ambadran/SIMACAS/Documentation/media/main_sch.jpg

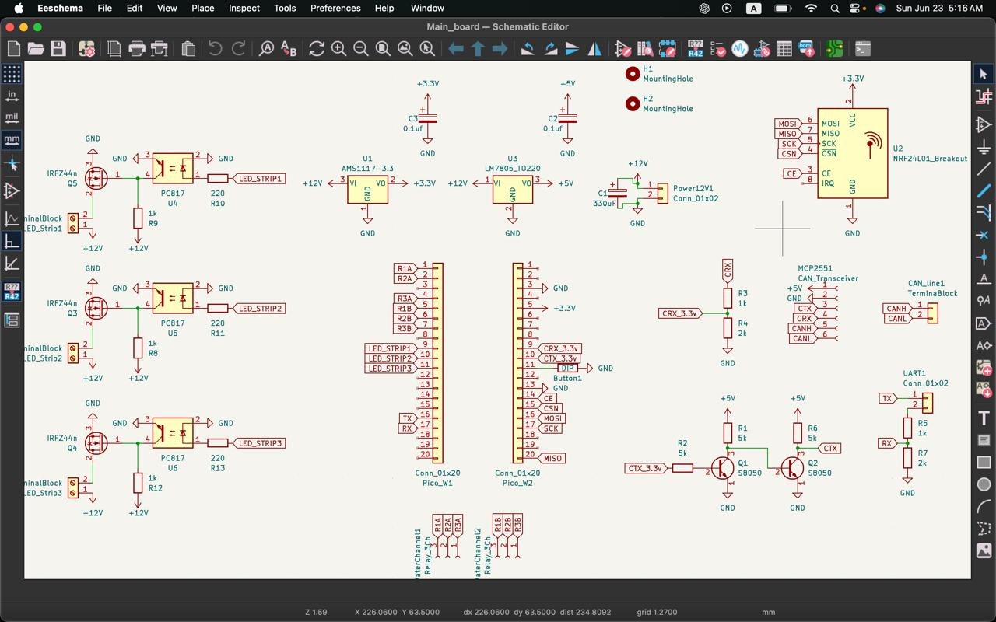
Documentation/media/main_sch.jpg
