ambadran/SIMACAS/Documentation/media/axis_sch.jpg

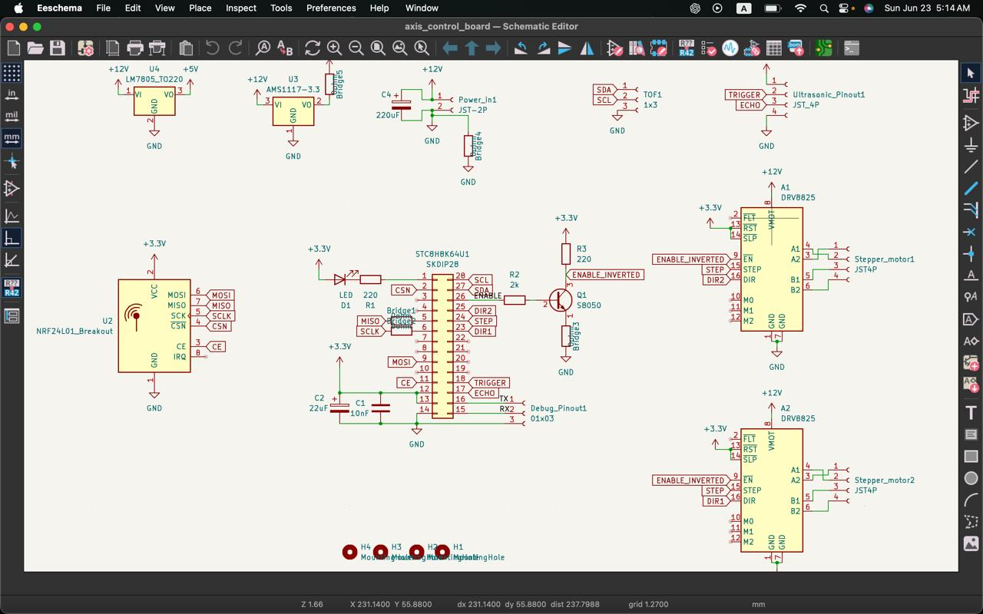
Documentation/media/axis_sch.jpg
