ambadran/SIMACAS/README.md

# SIMACAS - Smart Intillegent Monitoring and Control Agriculture System
