ambadran/SIMACAS/Programming/axis_controller/README.md

# STC8G1K08 Axis MCU

Take in commands from Main MCU through nRF24l01 and gives instructions to two stepper motor drivers DRV8825 to move the railing mechanism through aluminum profiles
