ambadran/SIMACAS/Documentation/media/1-3.png

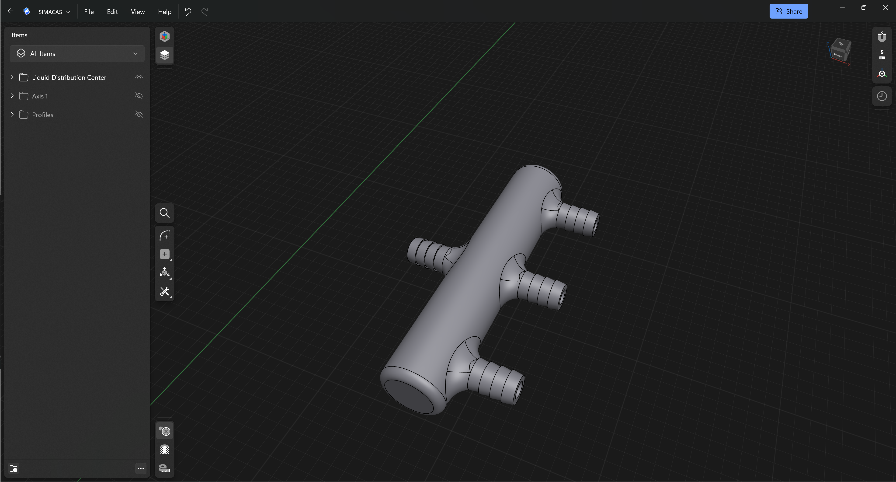
Documentation/media/1-3.png
