ambadran/SIMACAS/Documentation/media/actuators.html.jpg

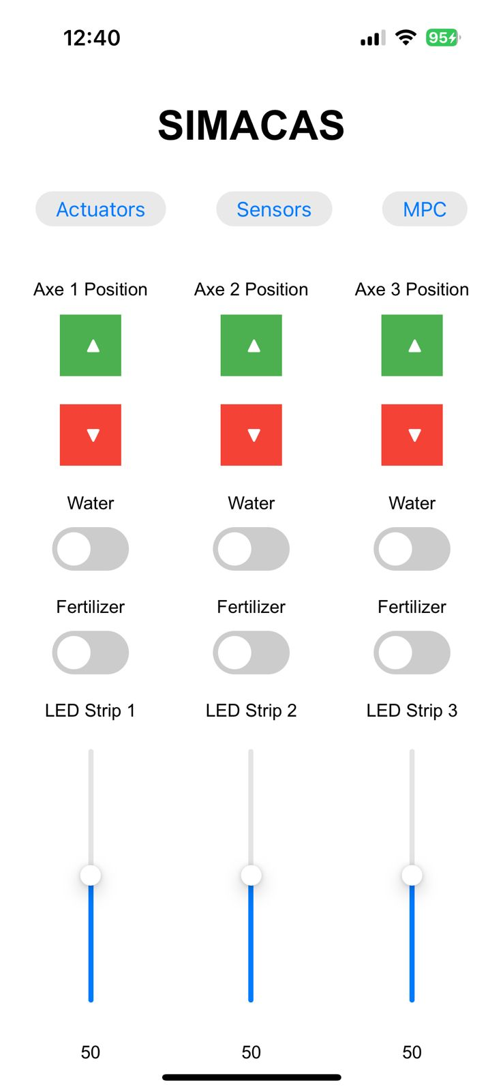
Documentation/media/actuators.html.jpg
