ambadran/SIMACAS/Documentation/media/axis_pcb.jpg

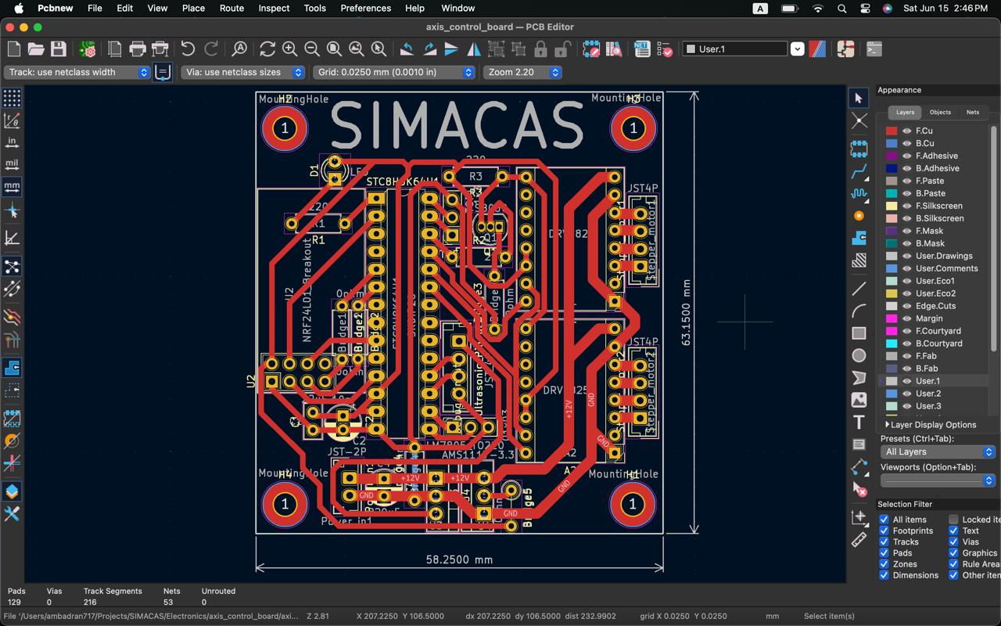
Documentation/media/axis_pcb.jpg
