ambadran/SIMACAS/Documentation/media/high_level_circuit.jpg

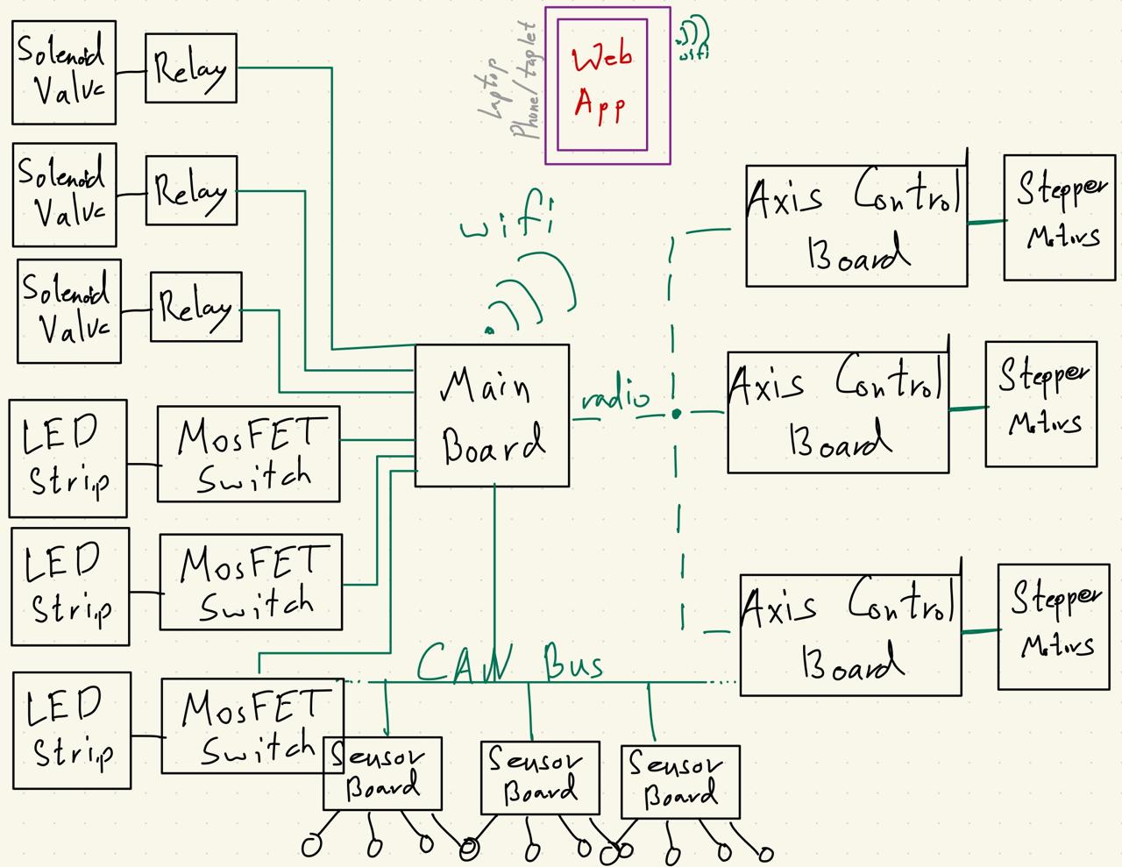
Documentation/media/high_level_circuit.jpg
