ambadran/SIMACAS/Documentation/media/left_axis.png

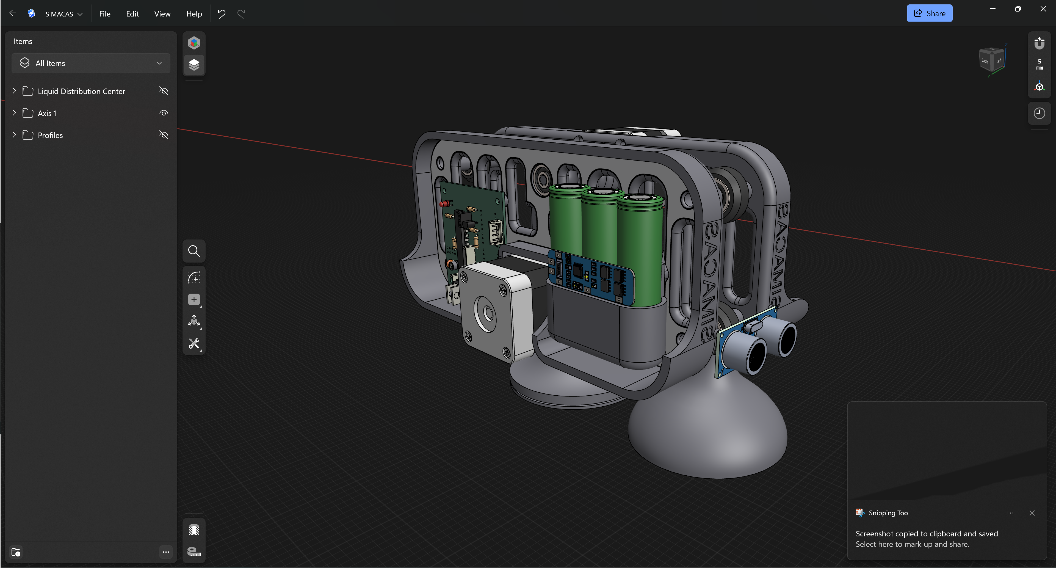
Documentation/media/left_axis.png
