ambadran/SIMACAS/Documentation/media/main_pcb.jpg

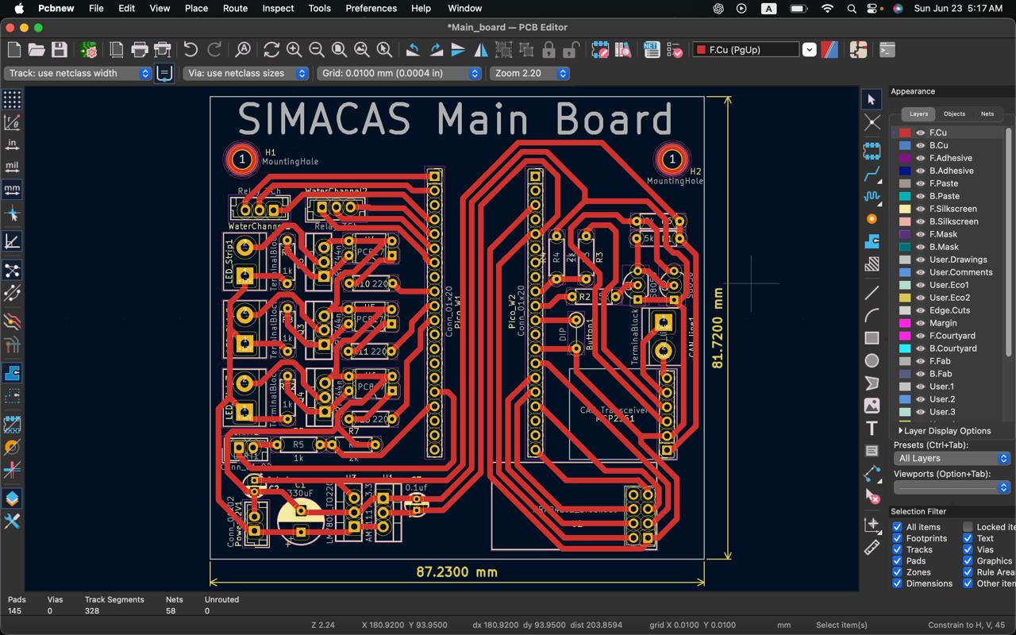
Documentation/media/main_pcb.jpg
