ambadran/SIMACAS/Documentation/media/mpc.html.jpg

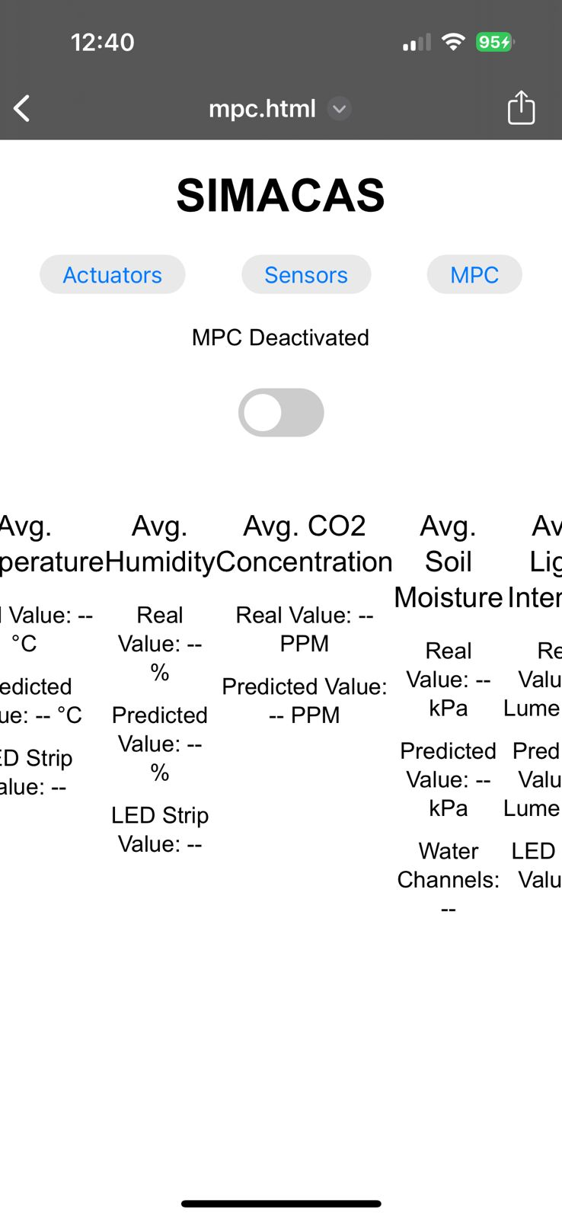
Documentation/media/mpc.html.jpg
