ambadran/SIMACAS/Documentation/media/right_axis.png

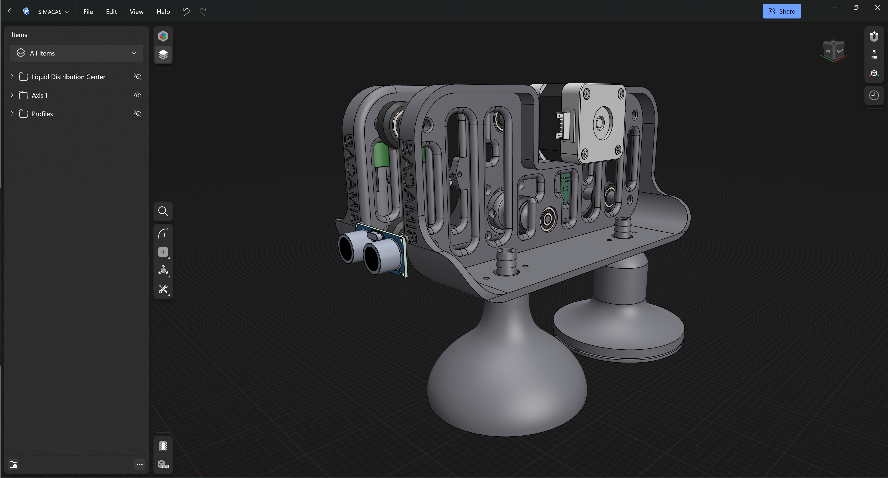
Documentation/media/right_axis.png
