ambadran/SIMACAS/Documentation/media/sensor_pcb.jpg

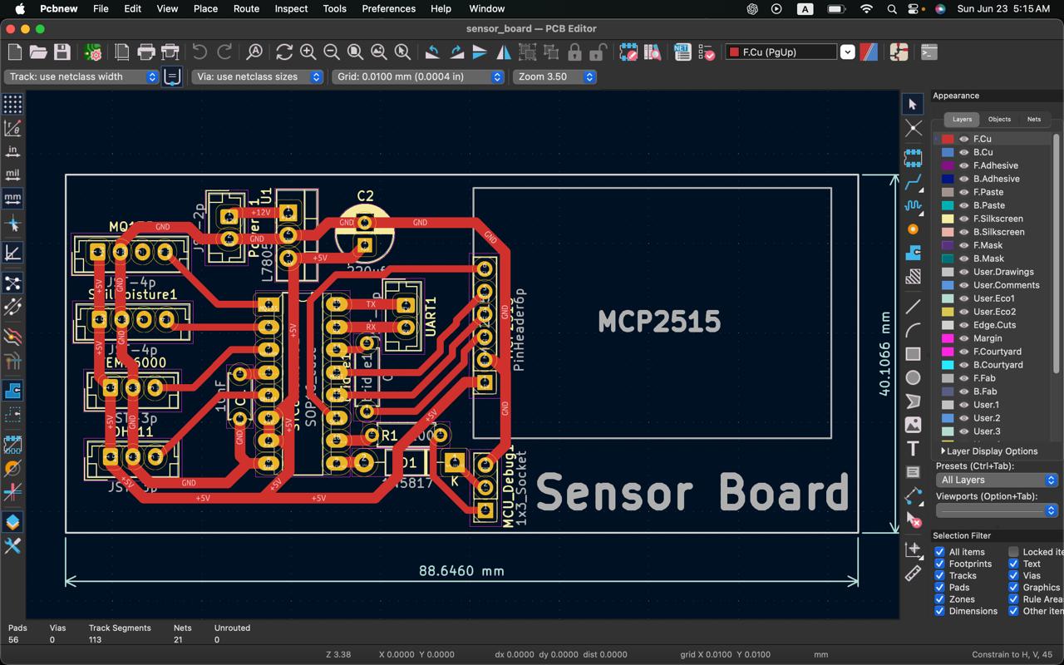
Documentation/media/sensor_pcb.jpg
