ambadran/SIMACAS/Documentation/media/sensor_sch.jpg

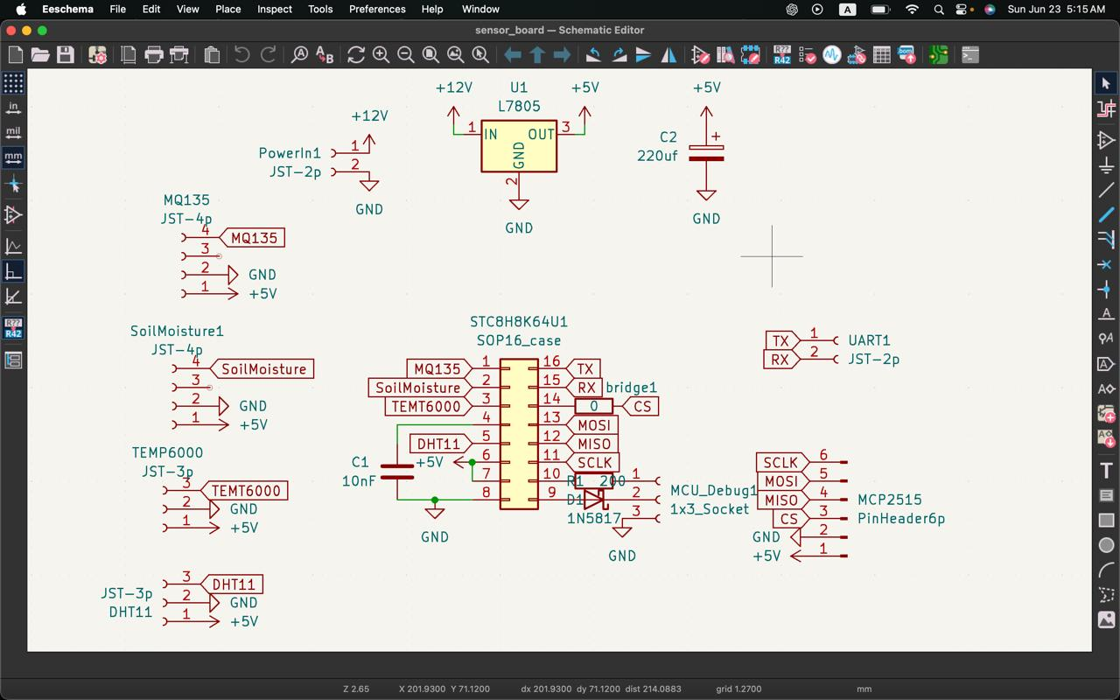
Documentation/media/sensor_sch.jpg
