ambadran/SIMACAS/Documentation/media/sensors.html.jpg

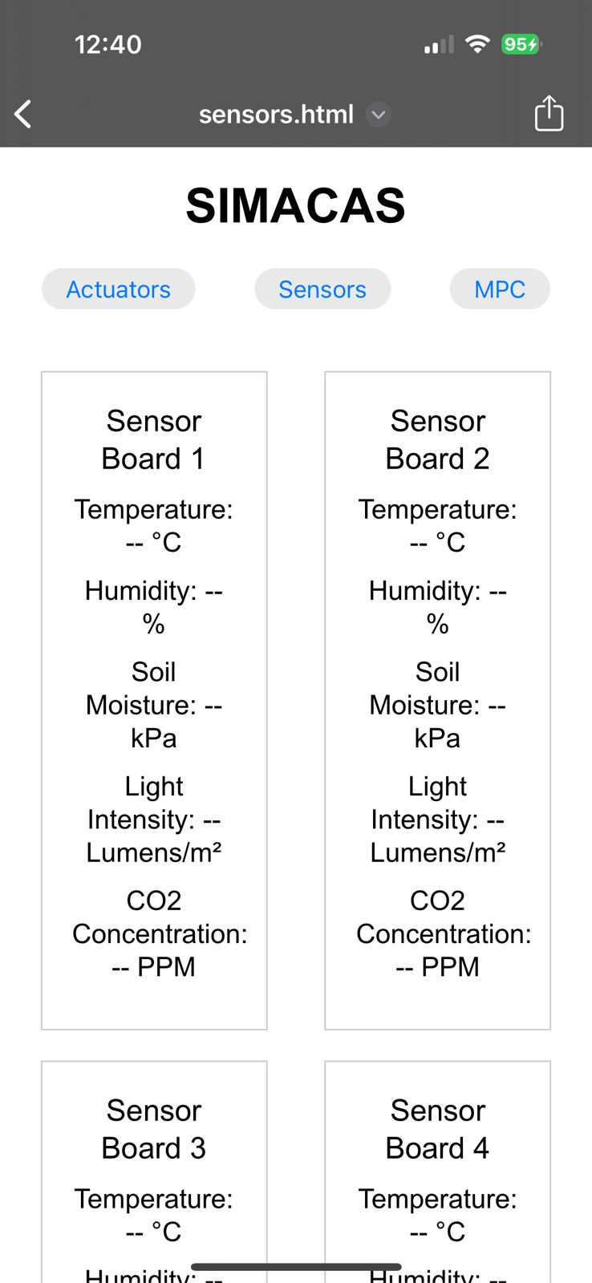
Documentation/media/sensors.html.jpg
