ambadran/SIMACAS/Documentation/media/water_distribution.png

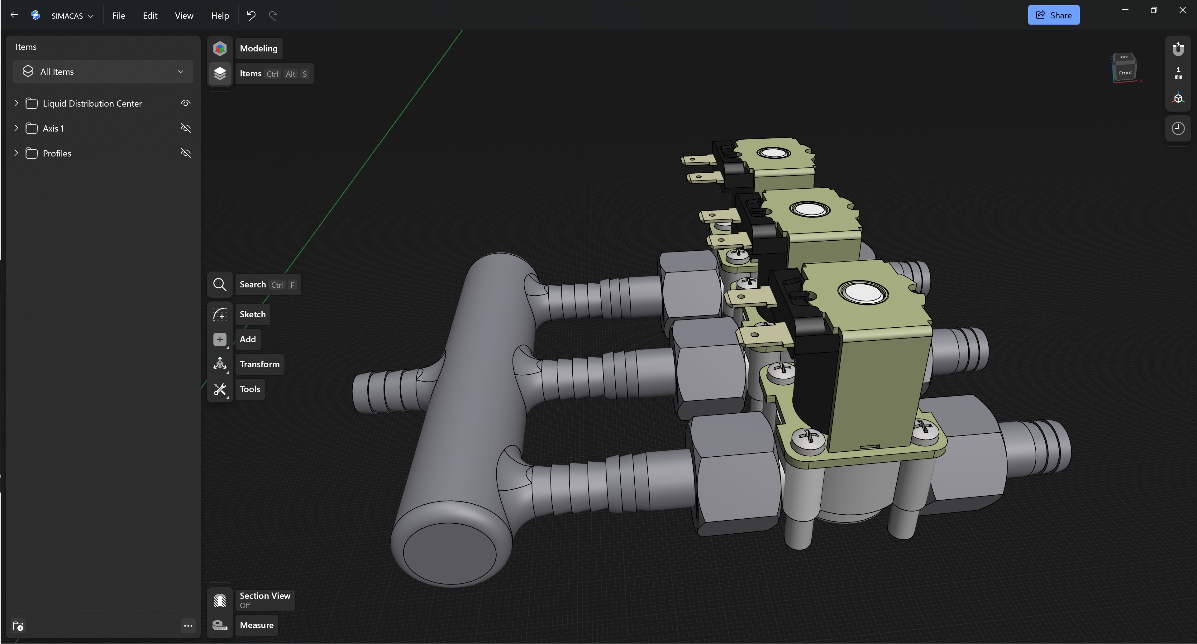
Documentation/media/water_distribution.png
