ambadran/SIMACAS/Documentation/media/water_distribution_circuit.jpg

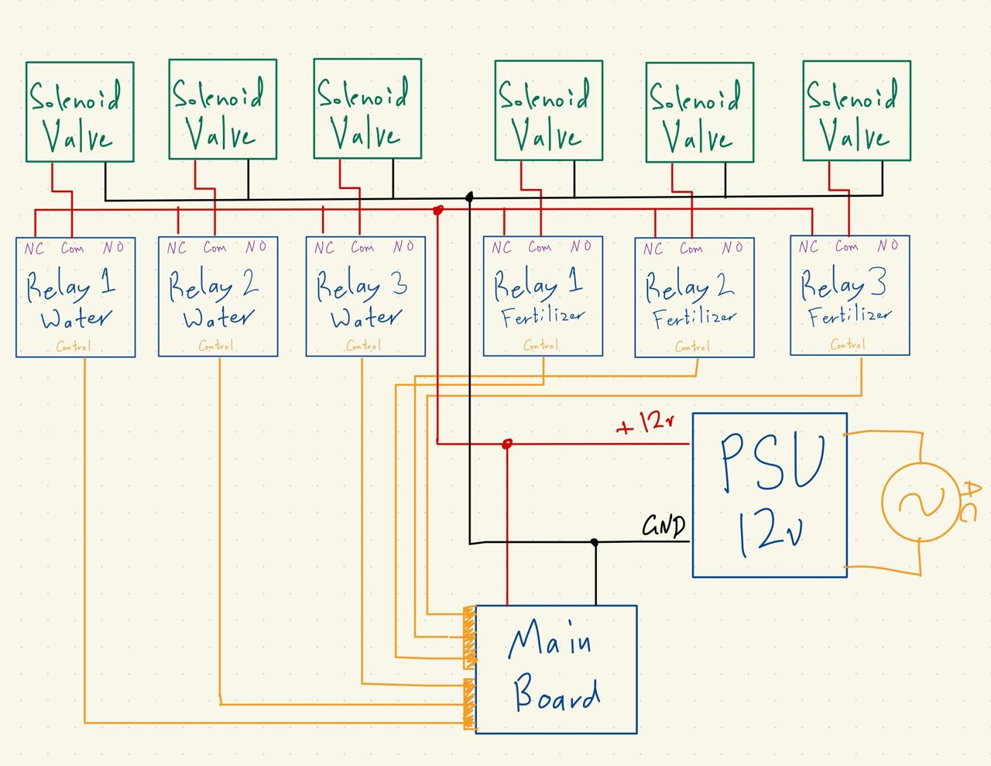
Documentation/media/water_distribution_circuit.jpg
