ambadran/SIMACAS/Documentation/media/wifi.jpg

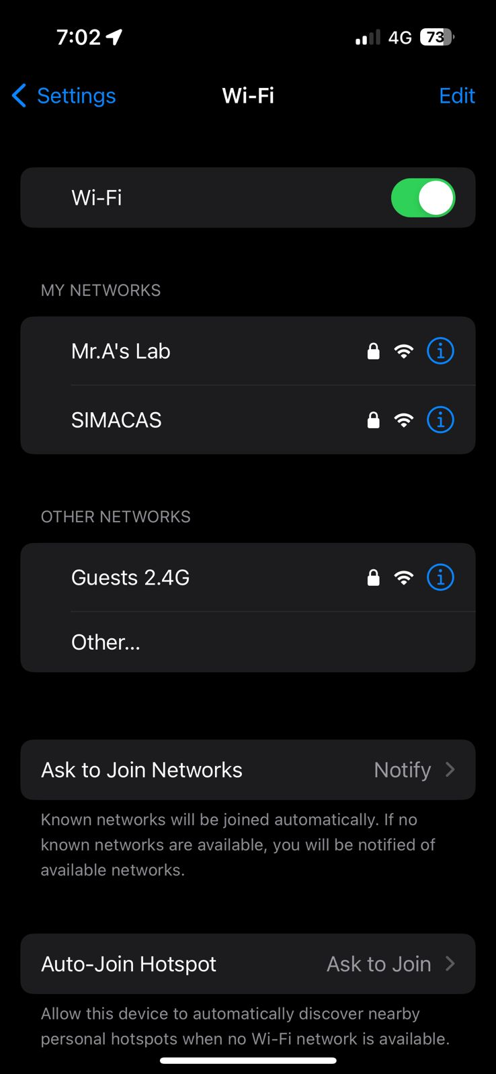
Documentation/media/wifi.jpg
