ambadran/SIMACAS/Documentation/BOM.xlsx

Sheet: Summary
No. | Name | Cost | Quantity | Total Cost | Description | Store
1 | Frame Assembly | 9313 | 1 | 9313
2 | Water Distribution System | 3359 | 1 | 3359
3 | Axis Traversal Robot Assembly | 2846 | 3 | 8538
4 | Power & Control Circuit Assembly | 3344.5 | 1 | 3344.5
*** | NOT BOUGHT |  |  | -2098
<> | Design, Manufacturing, Testing and Documentation |  |  | 20000
 | TOTAL |  |  | 42456.5

Sheet: NOT Bought
No. | Name | Cost | Quantity | Total Cost | Description | Store | Link
1 | Wood Sheet | 750 | 1 | 750
2 | Wood bolts | 1 | 20 | 20
5 | Profile L-Shaped connector | 20 | 12 | 240 | 3D corner connector between Top Frame and legs | UGE | https://uge-one.com/product/industrial-aluminum-profile-2020-european-standard-three-dimensional-angle-corner-connector/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
6 | T-Nut | 6 | 10 | 60 | Including T-Nut
7 | M5 1cm | 3 | 8 | 24
 | LED Strips
3 | Ultrasonic Sensor | 55 | 2 | 110
4 | Ultrasonic Wire | 30 | 2 | 60
5 | Ultrasonic screw | 1 | 4 | 4
6 | Fitting 3/4inch female to 1/2inch hose | 25 | 5 | 125
7 | hose 1/2 diameter | 15 | 27 | 405
8 | 3D printed sprinkler wide | 150 | 2 | 300
9 | LED Strips | 0 | 3 | 0 | not bought
10 | Wires for LED Strips | 0 | 1 | 0 | not bought
2 | STC8H8K64U_SOP20 | 65 | 1 | 65
3 | IC socket DIP28 | 8 | 1 | 8
 | TOTAL |  |  | 2098

Sheet: Frame Assembly
No. | Name | Cost | Quantity | Total Cost | Description | Store | Link
1 | Aluminum Profiles 2040 | 315 | 16 | 5040 | 2040 Profile for base (3+3+2+2+2*3+3) ~ 18m | 3dsmart
2 | Aluminum Profiles 2020 | 195 | 9 | 1755 | 2020 Profile for legs (2m*4) | 3dsmart
3 | Wood sheet | 750 | 1 | 750 | كنتر خشب للbase | المصانع
4 | Profile interior corner connector | 45 | 20 | 900 | inter-connections inside frame | UGE | https://uge-one.com/product/l-shape-3030-aluminum-profile-interior-corner-connector-joint-bracket/
5 | Profile L-Shaped connector | 20 | 24 | 480 | 3D corner connector between Top Frame and legs | UGE | https://uge-one.com/product/industrial-aluminum-profile-2020-european-standard-three-dimensional-angle-corner-connector/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
6 | T-Nut | 6 | 32 | 192 | Including T-Nut
7 | M5 1cm | 3 | 32 | 96
8 | M5 5cm | 4 | 20 | 80
9 | Wood Bolt | 1 | 20 | 20
 | TOTAL |  |  | 9313

Sheet: Axis Traversal Robot Assembly
No. | Name | Cost | Quantity | Total Cost | Description | Store | Link
1 | Left Side Frame | 3 | 180 | 540 | Sprinkler Side – 3D Printed /gram – 180g / Piece – 1 Piece
2 | Right Side Frame | 3 | 101 | 303 | Electronics Side – 3D Printed /gram – 101g / Piece – 1 Piece
3 | Battery Holder | 3 | 28 | 84 | 3D Printed /gram – 14g / Piece – 2 Pieces
4 | Spacers | 3 | 12 | 36 | 3D Printed /gram – 1g /Piece – 12 Pieces
5 | Motor Coupler | 3 | 12 | 36 | 3D Printed /gram – 6g /Piece – 2 Pieces
6 | Coupler Axis Connector | 3 | 4 | 12 | 3D Printed /gram – 2g /Piece – 2 Pieces
7 | V-Wheel Bearing | 55 | 6 | 330 | 2 v-wheels will have the inner ball bearings removed to fit in the coupler
 | Ball Bearings | 30 | 0 | 0 | the removed ball bearings will be used
8 | Stepper Motor | 100 | 2 | 200
10 | Stepper Motor Wire | 30 | 2 | 60
11 | Li-Ion 18650 Batteries | 50 | 3 | 150
12 | Li-Ion BMS 3s | 85 | 1 | 85
13 | Li-Ion Nickel Strips | 10 | 1 | 10
14 | Li-Ion Power Wires with JST | 20 | 1 | 20
15 | Ultrasonic Sensor | 55 | 1 | 55
16 | Ultrasonic Sensor Screw | 1 | 2 | 2
17 | Ultrasonic Sensor Wire | 30 | 1 | 30
18 | Assembled PCB | 877 | 1 | 877 | Details in “axis_control_pcb.xlsx”
9 | M3 Screws | 2 | 8 | 16 | For Stepper Motors, PCB and battery holder mounting
 | TOTAL |  |  | 2846

Sheet: Water Distribution System
No. | Name | Cost | Quantity | Total Cost | Description | Store
1 | hose 1/2 inch diameter | 15 | 30 | 450
2 | Fitting 3/4inch female to 1/2inch hose | 25 | 12 | 300 | From 1/2 inch diameter hose to 3/4 inch inlet of solenoid valve
3 | Water distributer 1 to 3 | 3 | 76 | 228 | 3D printed water distributer from 1 source to 6 outputs
4 | Solenoid Valves | 250 | 6 | 1500
5 | Hose tightenner | 2 | 16 | 32
6 | M3 Screw with nut | 3 | 4 | 12 | to hold sprinklers to axis traversal robot
7 | 3D Printed Sprinklers Narrow output | 3 | 129 | 387 | 1 sprinkler is 43 grams,
8 | 3D Printed Sprinklers Wide output | 3 | 150 | 450 | 1 sprinkler is 50 grams
 | TOTAL |  |  | 3359

Sheet: Power & Control Circuit Assembl
No. | Name | Cost | Quantity | Total Cost | Description | Store | Link
1 | AC head socket | 20 | 1 | 20
2 | AC Wire | 10 | 3 | 30
3 | Power supply 12v 10Amps | 375 | 1 | 375 | for solenoids and relays
4 | Power wire JST 2-pin | 20 | 1 | 20 | To power Main Board
5 | Assembled Main Board | 1639 | 1 | 1639 | Please Refer to “main_board.xlsx”
6 | MDF Board | 40 | 1 | 40 | to Hold Power Supply and Relay Modules
7 | M3 Screw and Nuts | 5 | 6 | 30 | to Hold Power Supply and Relay Modules
8 | Pin Header wires 3P | 5 | 2 | 10 | to connect to each relay modules
9 | Power Wires 1.5mm | 8 | 3 | 24 | To power Relay Channels
10 | Terminals | 2 | 12 | 24 | 2 terminals connectors for each solenoid (6 solenoids)
11 | Relay Module 12V 3Channel | 120 | 2 | 240
12 | MDF Board | 30 | 2 | 60 | to Hold the solenoid valves
13 | M5 Screws and Nuts | 5 | 6 | 30 | To hold the 3 MDF boards
14 | LED Strips | 0 | 3 | 0 | not bought
15 | Wires for LED Strips | 0 | 1 | 0 | not bought
16 | Power Wires 1mm | 6 | 3 | 18 | To connect Main Board to Sensor Board
17 | Assembled Sensor Board | 784.5 | 1 | 784.5 | with sensors
 | TOTAL |  |  | 3344.5

Sheet: Main Board
No. | Name | Cost | Quantity | Total Cost | Description | Store
1 | PCB | 400 | 1 | 400
2 | Pin Headers 1x20 | 12 | 2 | 24 | for raspberry pi pico w
3 | Raspberry Pi Pico W | 850 | 1 | 850
4 | Pin Header 2x3 | 2 | 1 | 2
5 | nRF24l01 | 110 | 1 | 110
6 | Resistors | 1 | 10 | 10
7 | S8050 | 2 | 2 | 4
8 | Pin Header 1x6 | 5 | 1 | 5
9 | MCP2551 | 460 | 1 | 460 | CAN Transceiver | future
10 | Terminal Block | 5 | 4 | 20 | 3 for led strip and 1 for CAN bus
11 | JST 3P Female | 3 | 2 | 6 | To connect to relays of solenoid valve
12 | PC817 | 3 | 3 | 9 | Optocoupler
13 | IRFZ44n | 3 | 25 | 75 | N-channel MOSFET
14 | JST 2P Female | 3 | 2 | 6 | 1 for power and 1 for UART output
15 | LD33v | 35 | 1 | 35 | 3.3v regulator
16 | L7805 | 15 | 1 | 15 | 5v regulator
17 | Capacitor 300uf | 4 | 1 | 4
18 | Capacitor 1nf | 2 | 2 | 4
 | TOTAL |  |  | 1639

Sheet: Axis Control Board
No. | Name | Cost | Quantity | Total Cost | Description | Store
1 | STC8H8K64U1 | 81 | 1 | 81 |  | UGE
2 | Female Pin headers 1x3 | 6 | 1 | 6 | MCU debugging
3 | IC socket 28pin | 7 | 1 | 7
4 | Female Pin Header 2x3 | 10 | 1 | 10 | nRF24 pinout
5 | nRF24l01 | 110 | 1 | 110 |  | circuits-elec
6 | LD33v | 35 | 1 | 35 |  | UGE
7 | lm7805 | 8 | 1 | 8 |  | UGE
9 | Female Pin Header 1x40 | 6 | 1 | 6 | DRV pinout
10 | DRV8825 | 140 | 2 | 280 |  | UGE
11 | S8050 | 3 | 1 | 3
12 | Resistors | 5 | 3 | 15 | 1k, 220x2
13 | JST female 2pin | 2 | 1 | 2 | Power in | UGE
14 | JST female 4pin | 2 | 3 | 6 | 2 stepper motors output and one ultrasonic input/output | UGE
15 | LED | 1 | 1 | 1
16 | Capacitor Electrolytic 220uF | 2 | 1 | 2
17 | Capacitor Electrolytic 22uF | 1 | 1 | 1
18 | Ceramic Capacitor | 2 | 2 | 4
19 | PCB board | 300 | 1 | 300
 | TOTAL |  |  | 877

Sheet: Sensor Board
No. | Name | Cost | Quantity | Total Cost | Description | Store
1 | PCB | 250 | 1 | 250
2 | STC8H8K64U_SOP20 | 65 | 1 | 65
3 | IC socket DIP28 | 8 | 1 | 8
4 | 1n5817 | 1 | 1 | 1 | Diode
5 | Resistors | 1 | 1 | 1
6 | 3-pin header | 2 | 1 | 2 | STC MCU Programming
7 | JST 2Pin | 3 | 2 | 6 | Power Input and UART Port
8 | JST 3Pin | 3 | 2 | 6 | TEMT600 and DHT11
9 | JST 4PIn | 3 | 2 | 6 | MQ135 and soil moisture
10 | Pin Header | 3 | 1 | 3 | MCP2515 breakout
11 | l7805 | 15 | 1 | 15
12 | Capacitor 220uf | 3 | 1 | 3
13 | Capacitor 0.1nF | 1 | 1 | 1
14 | Shrink Tube for wire | 2 | 1 | 2 | all wire lengths
15 | Female Pin header Wires | 5 | 14 | 70
16 | DHT11 | 65 | 1 | 65 | temperature and humidity
17 | MQ135 | 100 | 1 | 100
18 | Soil Moisture Sensor | 75 | 1 | 75
19 | TEMPT6000 | 85.50 | 1 | 85.5 | ambient light sensor
20 | MCP2515 Module | 270 | 1 | 270 | for CAN communication
 | TOTAL |  |  | 784.5
