ambadran/SIMACAS/Mechanics/SIMACAS.step

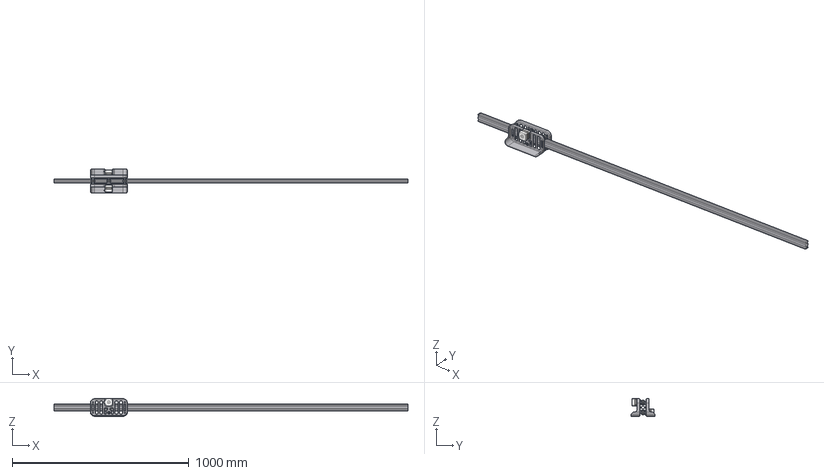
[picture p20: CAD file, 2024-04-13]
Mechanics/SIMACAS.step
2000.0 x 136.1 x 102.0 mm
Spacers (1)
Spacers
Top shaft support
Top Coupling
Top Motor Frame
Bottom Motor Frame
Top Back V Wheel
Bottom Back V Wheel
Top Front V Wheel
Bottom Front V Wheel
Profiles
