ambadran/SIMACAS/Mechanics/STLs/coupler_frame_connector.stl

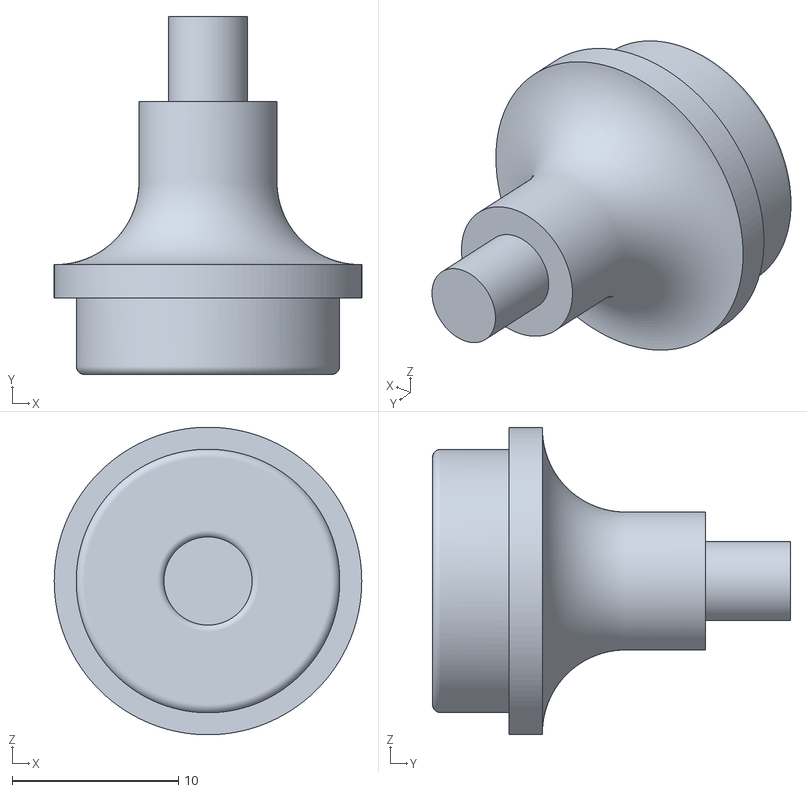
[picture p21: CAD file, 2024-06-25]
Mechanics/STLs/coupler_frame_connector.stl
18.5 x 21.5 x 18.5
