ambadran/SIMACAS/Mechanics/STLs/motor_coupler.stl

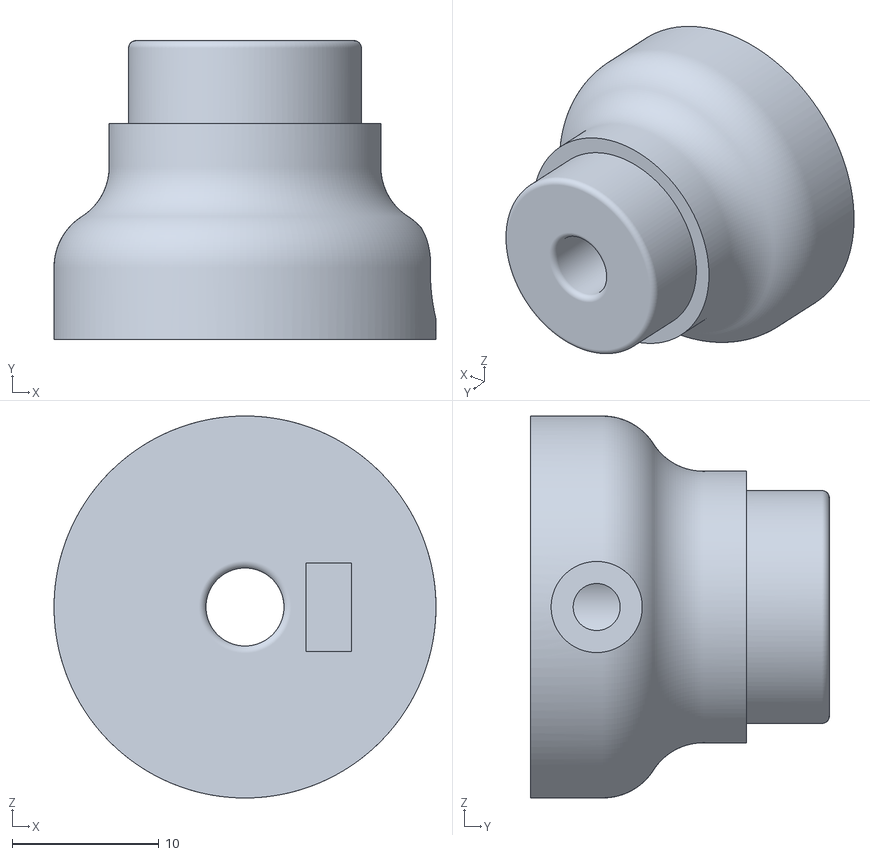
[picture p22: CAD file, 2024-06-25]
Mechanics/STLs/motor_coupler.stl
26.0 x 20.3 x 26.0
