ambadran/SIMACAS/Mechanics/STLs/sprinkler_wide_top.stl

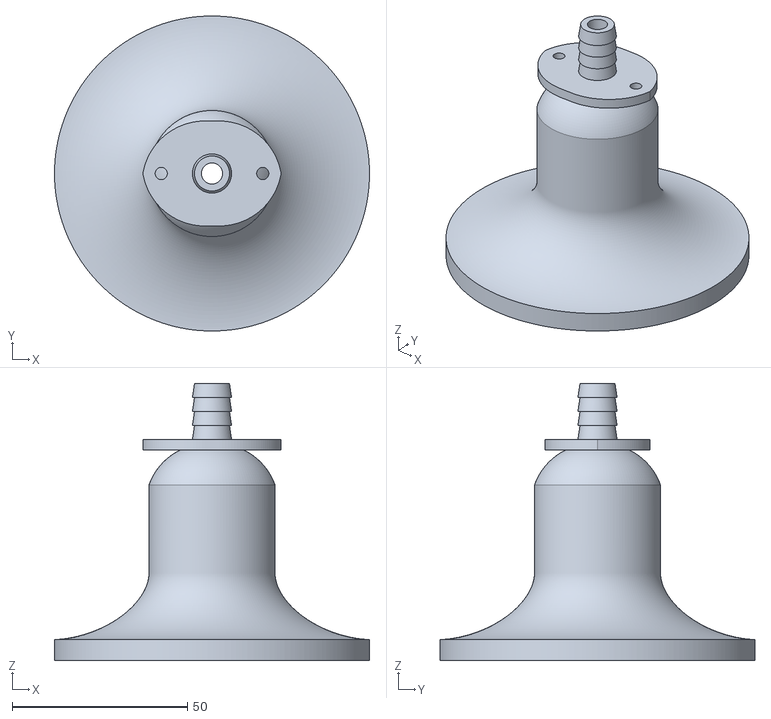
[picture p23: CAD file, 2024-06-23]
Mechanics/STLs/sprinkler_wide_top.stl
90.0 x 90.0 x 79.2
