ambadran/SIMACAS/Mechanics/STLs/sprinkler_wide_base.stl

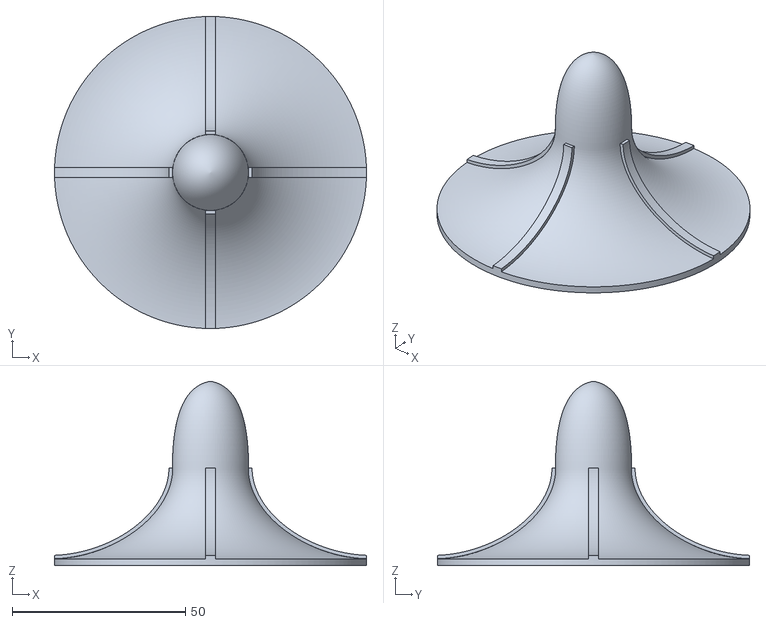
[picture p24: CAD file, 2024-06-23]
Mechanics/STLs/sprinkler_wide_base.stl
90.0 x 90.0 x 53.2
