ambadran/SIMACAS/Mechanics/STLs/spacer.stl

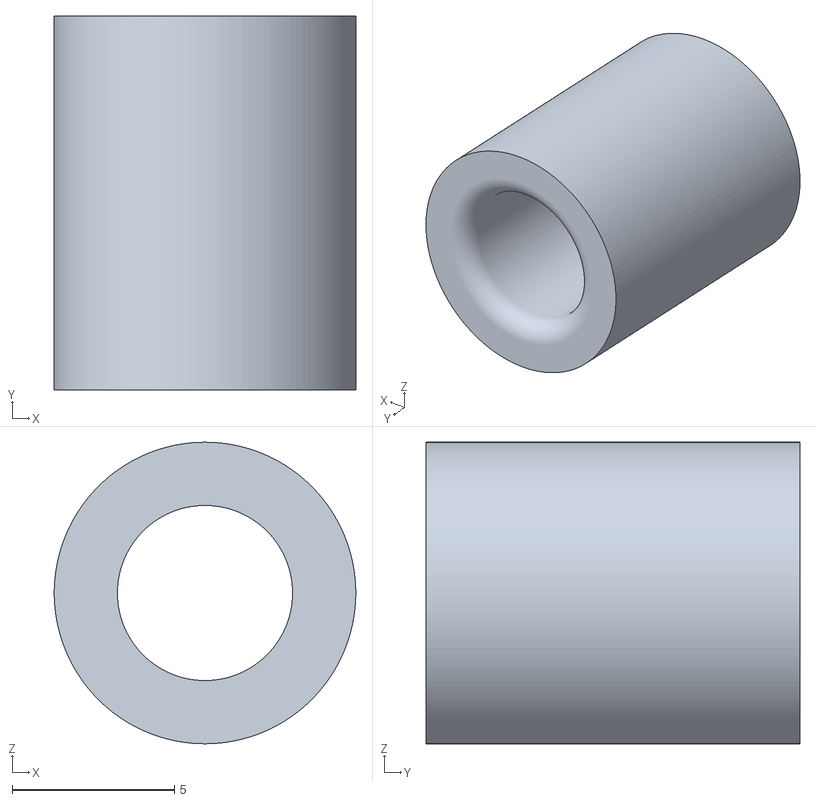
[picture p25: CAD file, 2024-06-23]
Mechanics/STLs/spacer.stl
9.30 x 11.5 x 9.30
