ambadran/SIMACAS/Mechanics/STLs/batteries_holder.stl

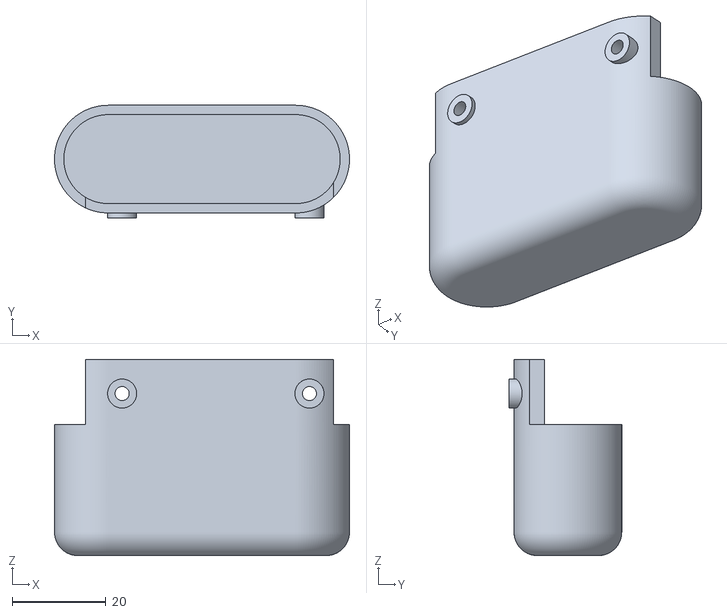
[picture p26: CAD file, 2024-06-18]
Mechanics/STLs/batteries_holder.stl
63.0 x 24.0 x 41.9
