ambadran/SIMACAS/Electronics/Main_board/PDF/silk.pdf

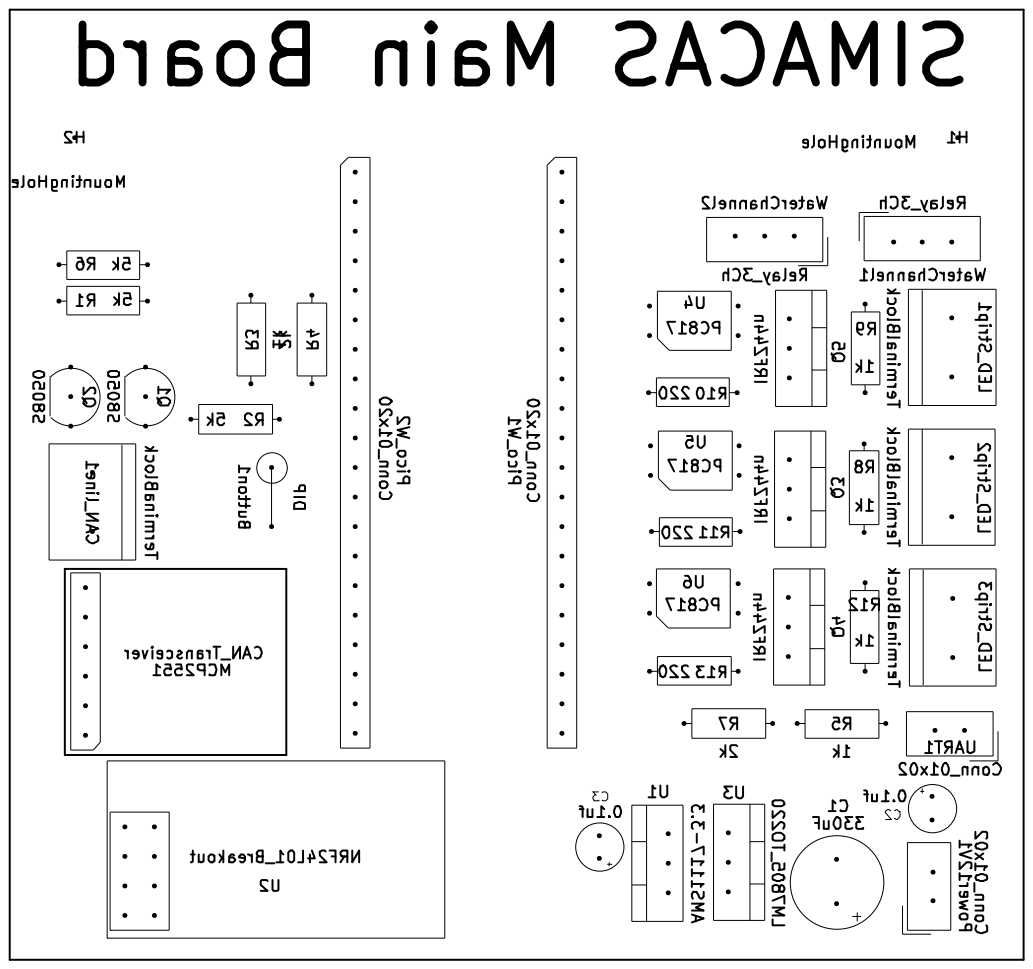
[picture p27: page 1]
