ambadran/SIMACAS/Electronics/Main_board/PDF/traces.pdf

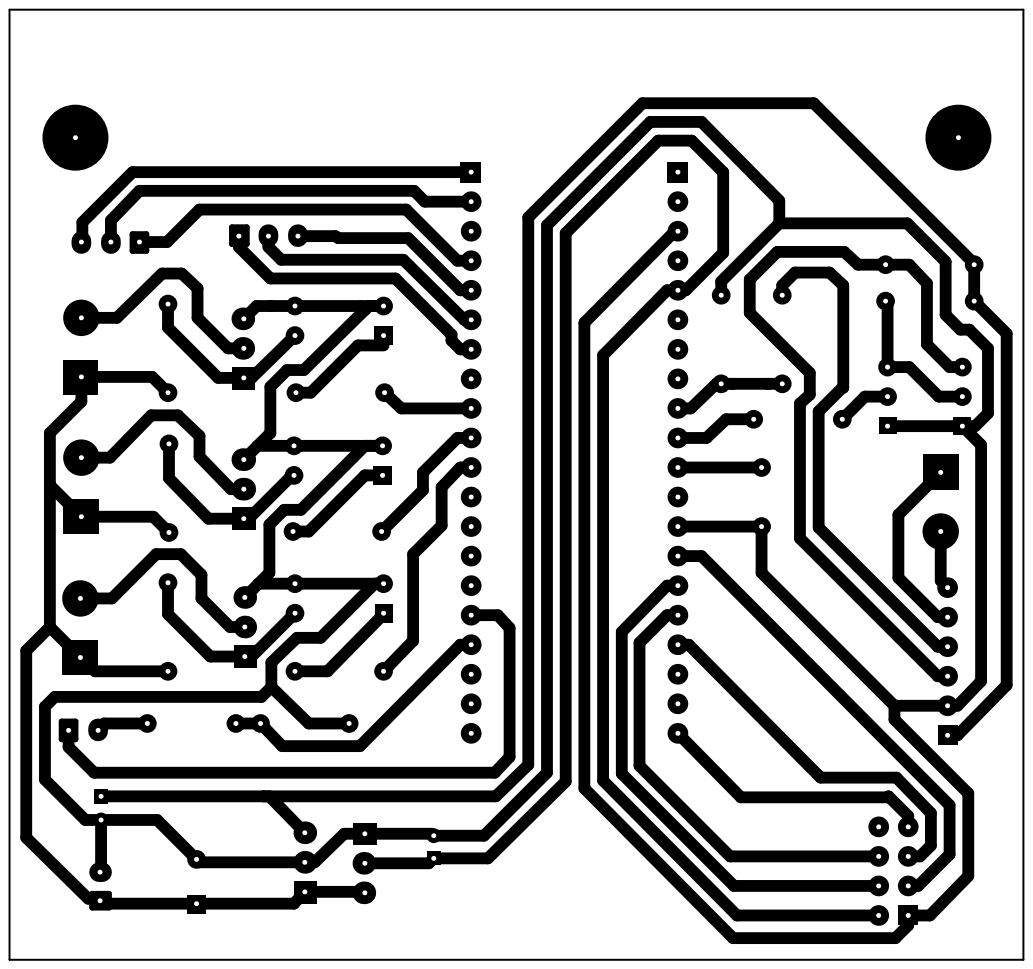
[picture p28: page 1]
