ambadran/SIMACAS/Electronics/axis_control_board/PDF/back_traces.pdf

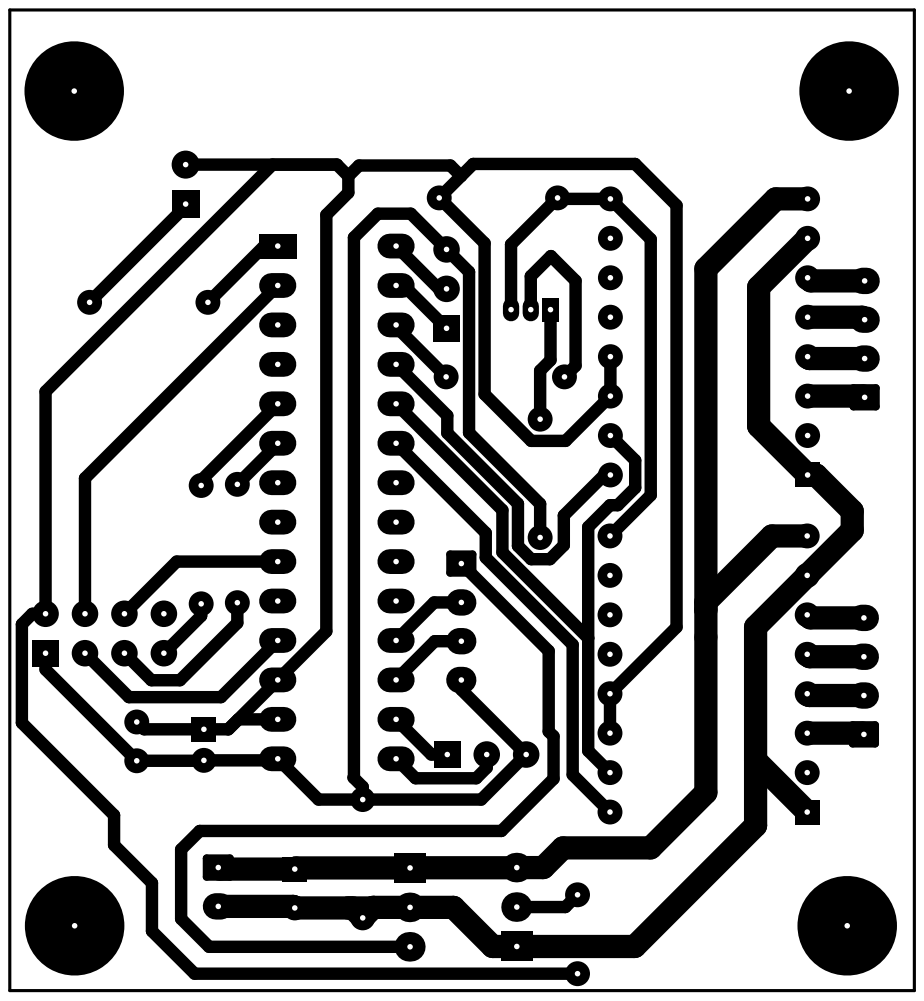
[picture p29: page 1]
