ambadran/SIMACAS/Electronics/axis_control_board/PDF/front_silk.pdf

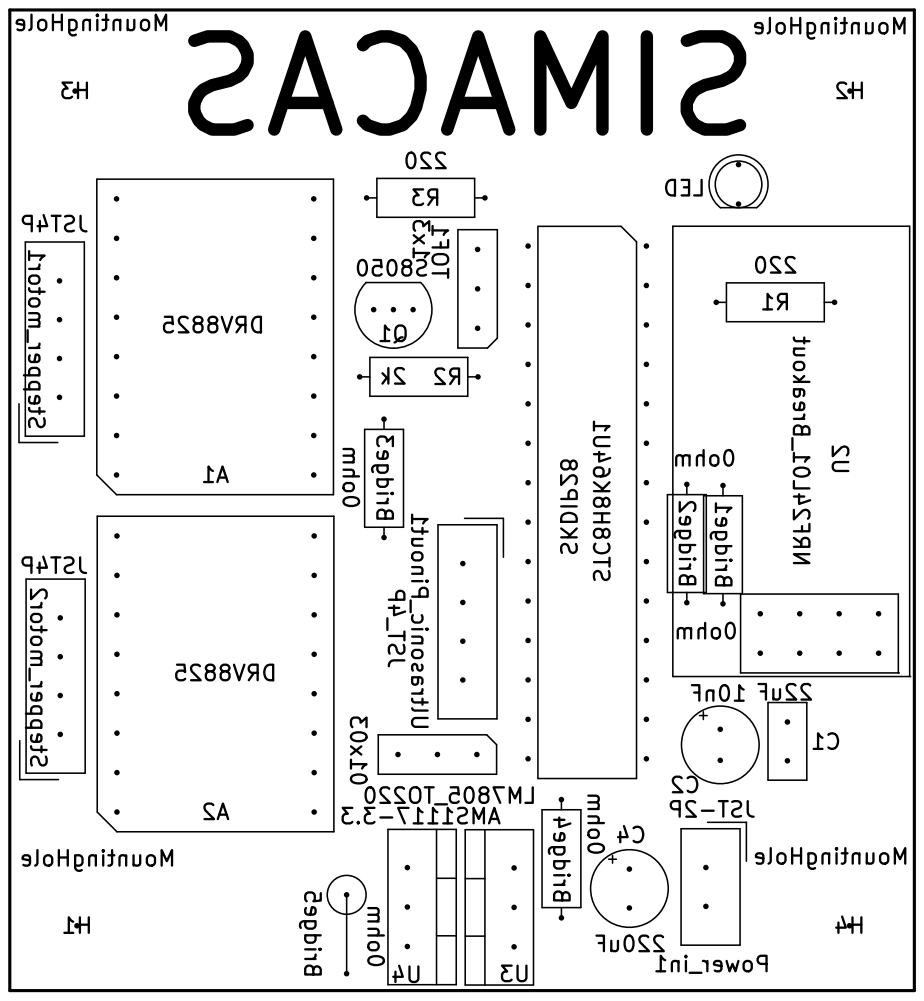
[picture p30: page 1]
