ambadran/SIMACAS/Electronics/sensor_board/PDF/silk.pdf

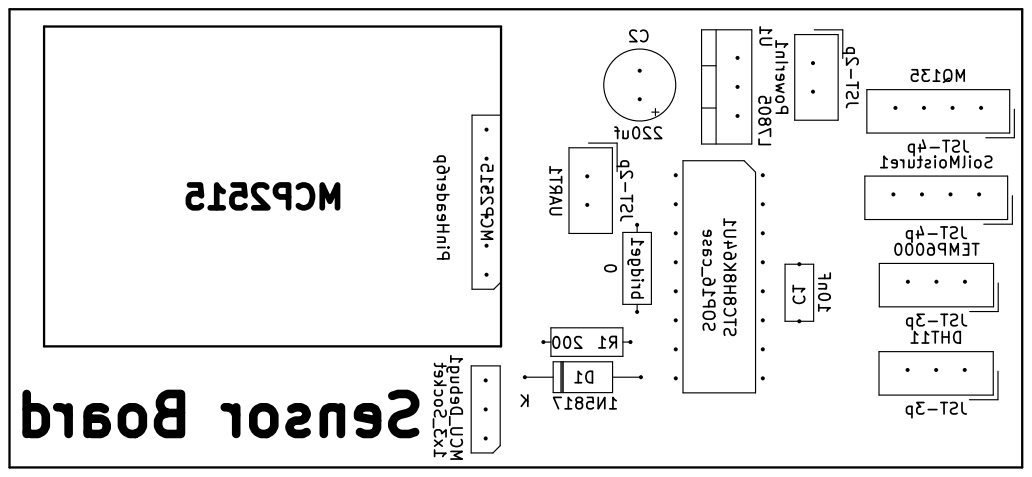
[picture p31: page 1]
