ambadran/SIMACAS/Electronics/sensor_board/PDF/traces.pdf

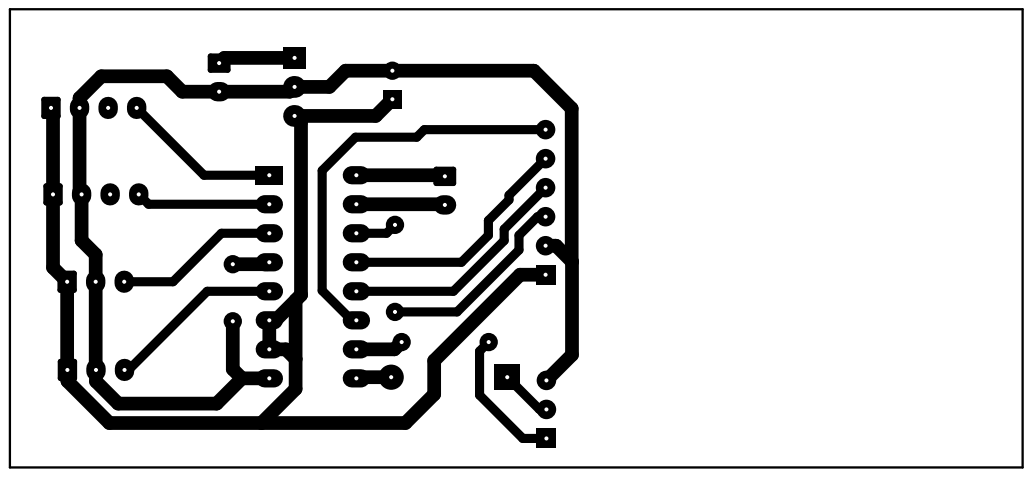
[picture p32: page 1]
