ambadran/SIMACAS/Electronics/Main_board/Main_board.kicad_pcb

## KiCad design Electronics/Main_board/Main_board.kicad_pcb (2024-06-24)

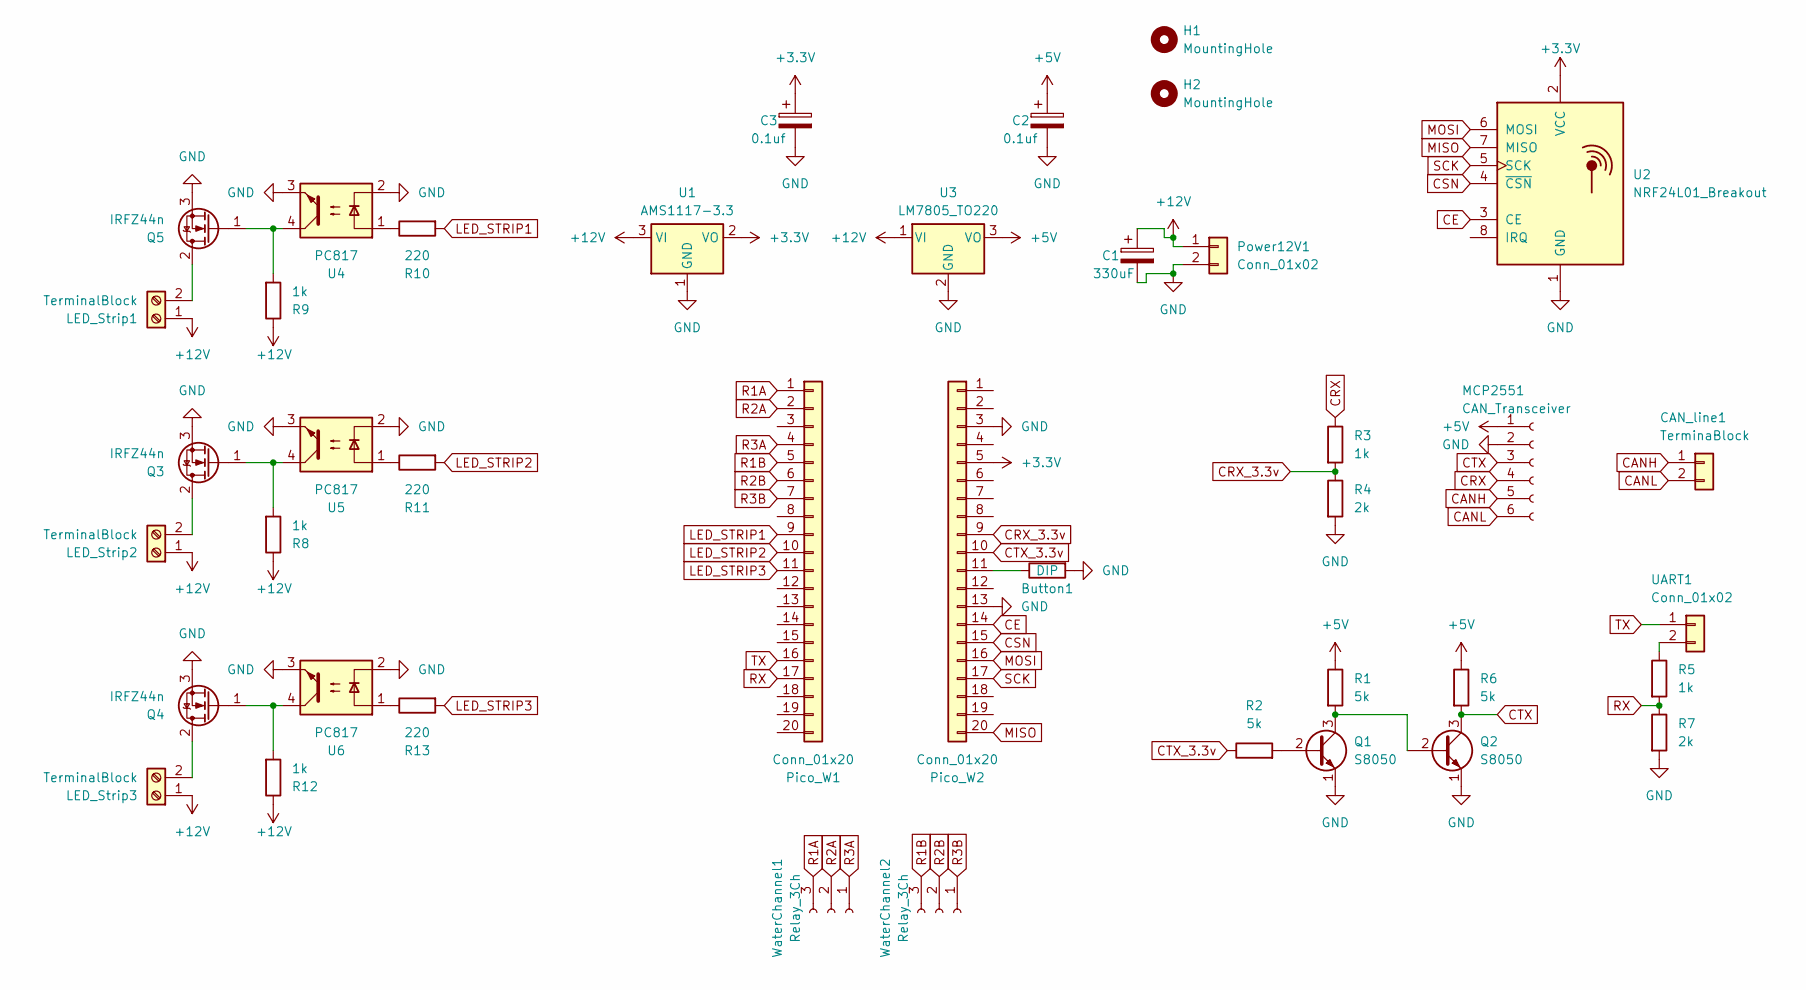
[picture p33: schematic Main_board.kicad_sch]

Parts:
Button1: DIP; R_Axial_DIN0207_L6.3mm_D2.5mm_P5.08mm_Vertical
C1: 330uF; CP_Radial_D8.0mm_P3.80mm
C2, C3: 0.1uf; CP_Radial_D4.0mm_P2.00mm
CAN_line1: TerminaBlock; TerminalBlock_bornier-2_P5.08mm
H1, H2: MountingHole; MountingHole_3.2mm_M3_DIN965_Pad_TopBottom
LED_Strip1, LED_Strip2, LED_Strip3: TerminalBlock; TerminalBlock_bornier-2_P5.08mm
MCP2551: CAN_Transceiver; PinSocket_1x06_P2.54mm_Vertical
Pico_W1, Pico_W2: Conn_01x20; PinSocket_1x20_P2.54mm_Vertical
Power12V1: Conn_01x02; JST_EH_B2B-EH-A_1x02_P2.50mm_Vertical
Q1, Q2: S8050; TO-92_Inline_Wide
Q3, Q4, Q5: IRFZ44n; TO-220-3_Vertical
R1, R2, R6: 5k; R_Axial_DIN0207_L6.3mm_D2.5mm_P7.62mm_Horizontal
R3, R5, R8, R9, R12: 1k; R_Axial_DIN0207_L6.3mm_D2.5mm_P7.62mm_Horizontal
R4, R7: 2k; R_Axial_DIN0207_L6.3mm_D2.5mm_P7.62mm_Horizontal
R10, R11, R13: 220; R_Axial_DIN0207_L6.3mm_D2.5mm_P7.62mm_Horizontal
U1: AMS1117-3.3; TO-220-3_Vertical
U2: NRF24L01_Breakout; nRF24L01_Breakout
U3: LM7805_TO220; TO-220-3_Vertical
U4, U5, U6: PC817; DIP-4_W7.62mm
UART1: Conn_01x02; JST_EH_B2B-EH-A_1x02_P2.50mm_Vertical
WaterChannel1, WaterChannel2: Relay_3Ch; JST_EH_B3B-EH-A_1x03_P2.50mm_Vertical

Connections:
+3.3V: C3.1, Pico_W2.5, U1.2 (VO), U2.2 (VCC)
+5V: C2.1, MCP2551.1, R1.1, R6.1, U3.3 (VO)
+12V: C1.1, LED_Strip1.1, LED_Strip2.1, LED_Strip3.1, Power12V1.1, R8.1, R9.1, R12.1, U1.3 (VI), U3.1 (VI)
CANH: CAN_line1.1, MCP2551.5
CANL: CAN_line1.2, MCP2551.6
CE: Pico_W2.14, U2.3 (CE)
CRX: MCP2551.4, R3.1
CRX_3.3v: Pico_W2.9, R3.2, R4.1
CSN: Pico_W2.15, U2.4 (~CSN)
CTX: MCP2551.3, Q2.3 (C), R6.2
CTX_3.3v: Pico_W2.10, R2.1
GND: Button1.2, C1.2, C2.2, C3.2, MCP2551.2, Pico_W2.3, Pico_W2.13, Power12V1.2, Q1.1 (E), Q2.1 (E), Q3.3 (S), Q4.3 (S), Q5.3 (S), R4.2, R7.2, U1.1 (GND), U2.1 (GND), U3.2 (GND), U4.2, U4.3, U5.2, U5.3, U6.2, U6.3
LED_STRIP1: Pico_W1.9, R10.2
LED_STRIP2: Pico_W1.10, R11.2
LED_STRIP3: Pico_W1.11, R13.2
MISO: Pico_W2.20, U2.7 (MISO)
MOSI: Pico_W2.16, U2.6 (MOSI)
unnamed: LED_Strip1.2, Q5.2 (D)
unnamed: LED_Strip2.2, Q3.2 (D)
unnamed: LED_Strip3.2, Q4.2 (D)
unnamed: Button1.1, Pico_W2.11
unnamed: Q1.2 (B), R2.2
unnamed: Q1.3 (C), Q2.2 (B), R1.2
unnamed: Q3.1 (G), R8.2, U5.4
unnamed: Q4.1 (G), R12.2, U6.4
unnamed: Q5.1 (G), R9.2, U4.4
unnamed: R10.1, U4.1
unnamed: R11.1, U5.1
unnamed: R13.1, U6.1
unnamed: R5.1, UART1.2
R1A: Pico_W1.1, WaterChannel1.3
R1B: Pico_W1.5, WaterChannel2.3
R2A: Pico_W1.2, WaterChannel1.2
R2B: Pico_W1.6, WaterChannel2.2
R3A: Pico_W1.4, WaterChannel1.1
R3B: Pico_W1.7, WaterChannel2.1
RX: Pico_W1.17, R5.2, R7.1
SCK: Pico_W2.17, U2.5 (SCK)
TX: Pico_W1.16, UART1.1

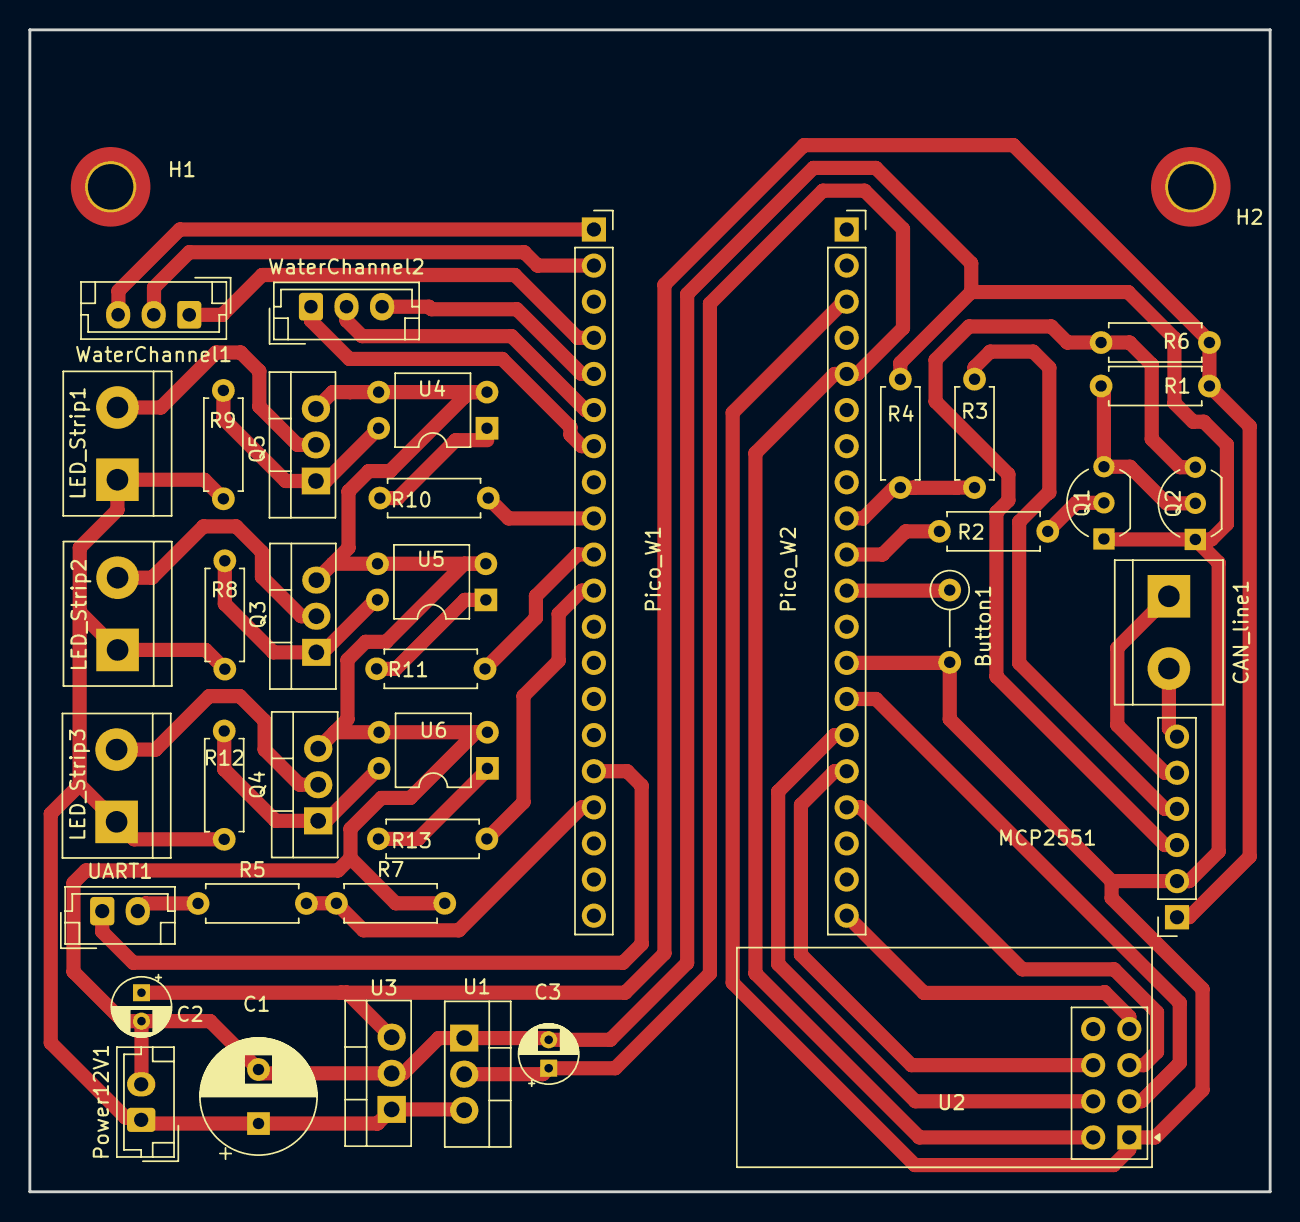
[picture p34: board Main_board.kicad_pcb from above]

Board: 2 copper layers, 87.2 x 81.7 mm, 41 parts (0 on the bottom side), 39 nets.
