ambadran/SIMACAS/Electronics/sensor_board/sensor_board.kicad_pcb

## KiCad design Electronics/sensor_board/sensor_board.kicad_pcb (2024-06-17)

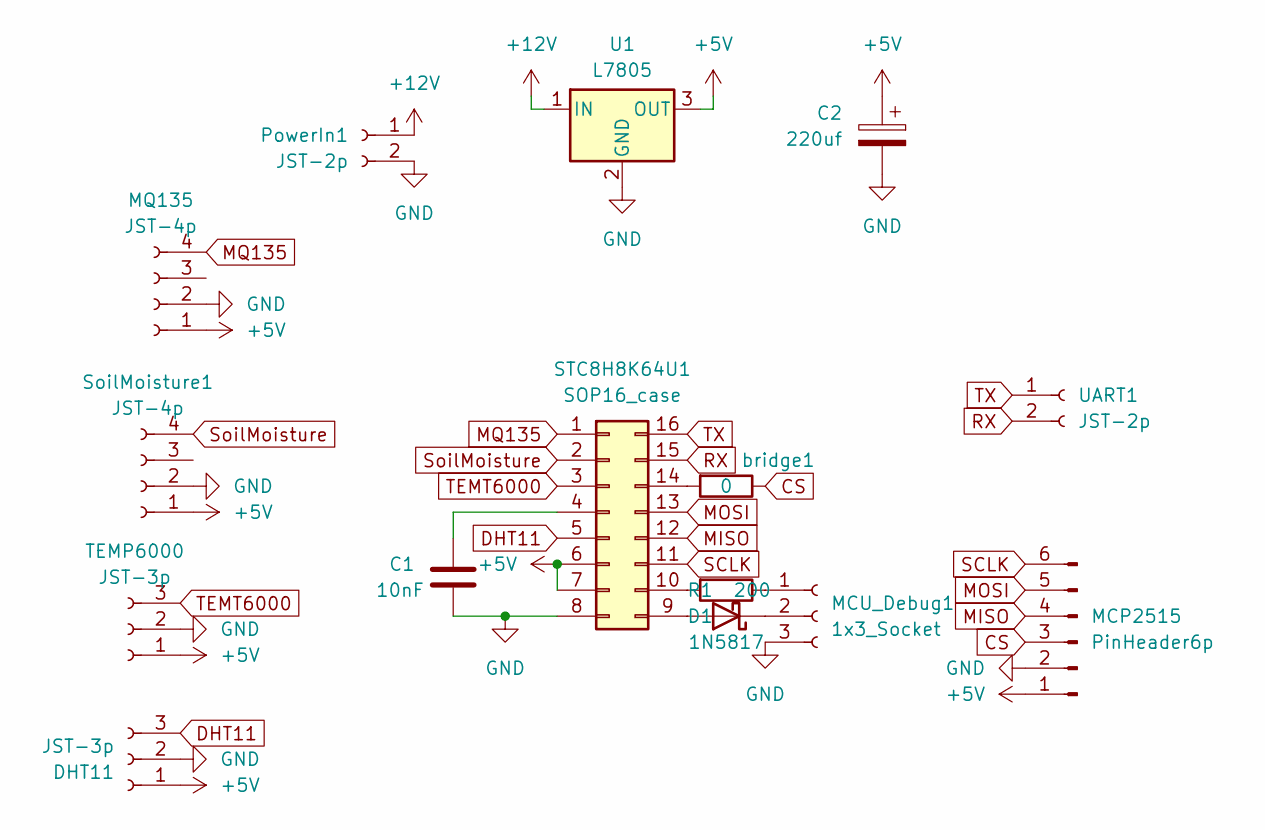
[picture p35: schematic sensor_board.kicad_sch]

Parts:
C1: 10nF; C_Disc_D5.0mm_W2.5mm_P5.00mm
C2: 220uf; CP_Radial_D6.3mm_P2.50mm
D1: 1N5817; D_DO-41_SOD81_P10.16mm_Horizontal
DHT11: JST-3p; JST_EH_B3B-EH-A_1x03_P2.50mm_Vertical
MCP2515: PinHeader6p; PinSocket_1x06_P2.54mm_Vertical
MCU_Debug1: 1x3_Socket; PinSocket_1x03_P2.54mm_Vertical
MQ135: JST-4p; JST_EH_B4B-EH-A_1x04_P2.50mm_Vertical
PowerIn1: JST-2p; JST_EH_B2B-EH-A_1x02_P2.50mm_Vertical
R1: 200; R_Axial_DIN0207_L6.3mm_D2.5mm_P7.62mm_Horizontal
STC8H8K64U1: SOP16_case; DIP-16_W7.62mm_LongPads
SoilMoisture1: JST-4p; JST_EH_B4B-EH-A_1x04_P2.50mm_Vertical
TEMP6000: JST-3p; JST_EH_B3B-EH-A_1x03_P2.50mm_Vertical
U1: L7805; TO-220-3_Vertical
UART1: JST-2p; JST_EH_B2B-EH-A_1x02_P2.50mm_Vertical
bridge1: 0; R_Axial_DIN0207_L6.3mm_D2.5mm_P7.62mm_Horizontal

Connections:
+5V: C2.1, DHT11.1, MCP2515.1, MQ135.1, STC8H8K64U1.6, STC8H8K64U1.7, SoilMoisture1.1, TEMP6000.1, U1.3 (OUT)
+12V: PowerIn1.1, U1.1 (IN)
CS: MCP2515.3, bridge1.1
DHT11: DHT11.3, STC8H8K64U1.5
GND: C1.2, C2.2, DHT11.2, MCP2515.2, MCU_Debug1.3, MQ135.2, PowerIn1.2, STC8H8K64U1.8, SoilMoisture1.2, TEMP6000.2, U1.2 (GND)
MISO: MCP2515.4, STC8H8K64U1.12
MOSI: MCP2515.5, STC8H8K64U1.13
MQ135: MQ135.4, STC8H8K64U1.1
unnamed: D1.2 (A), STC8H8K64U1.9
unnamed: D1.1 (K), MCU_Debug1.2
unnamed: MCU_Debug1.1, R1.1
unnamed: C1.1, STC8H8K64U1.4
unnamed: R1.2, STC8H8K64U1.10
unnamed: STC8H8K64U1.14, bridge1.2
RX: STC8H8K64U1.15, UART1.2
SCLK: MCP2515.6, STC8H8K64U1.11
SoilMoisture: STC8H8K64U1.2, SoilMoisture1.4
TEMT6000: STC8H8K64U1.3, TEMP6000.3
TX: STC8H8K64U1.16, UART1.1

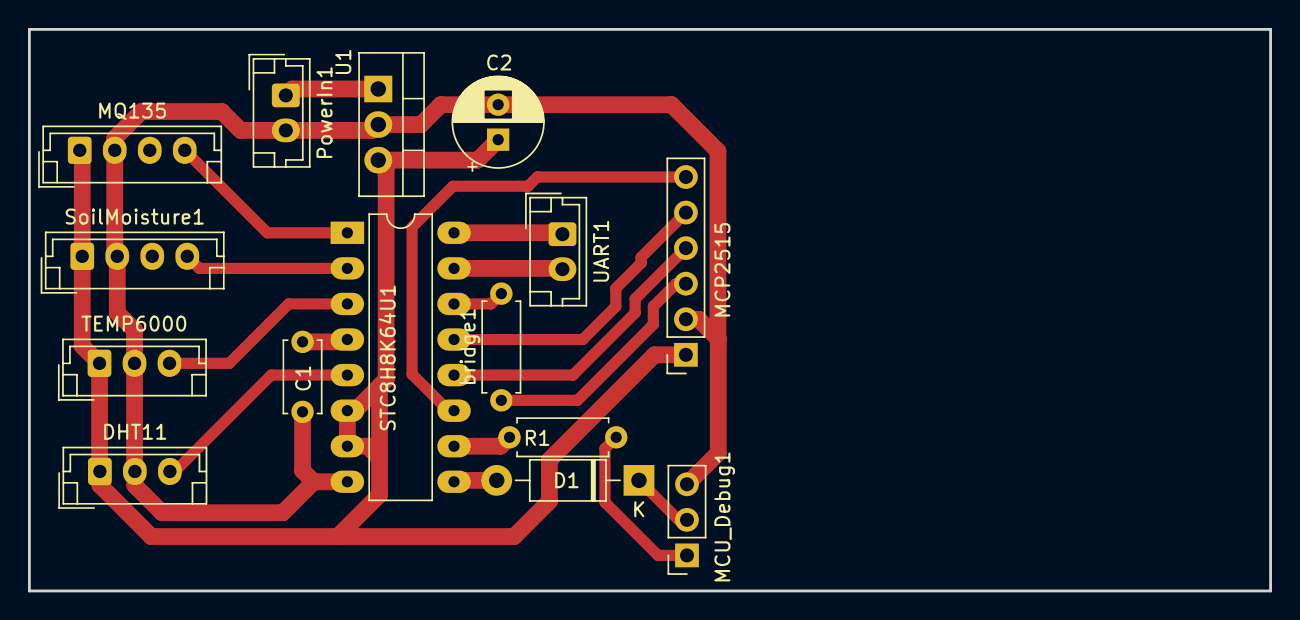
[picture p36: board sensor_board.kicad_pcb from above]

Board: 2 copper layers, 88.6 x 40.1 mm, 15 parts (0 on the bottom side), 19 nets.
