ambadran/SIMACAS/Electronics/axis_control_board/axis_control_board.kicad_pcb

## KiCad design Electronics/axis_control_board/axis_control_board.kicad_pcb (2024-06-17)

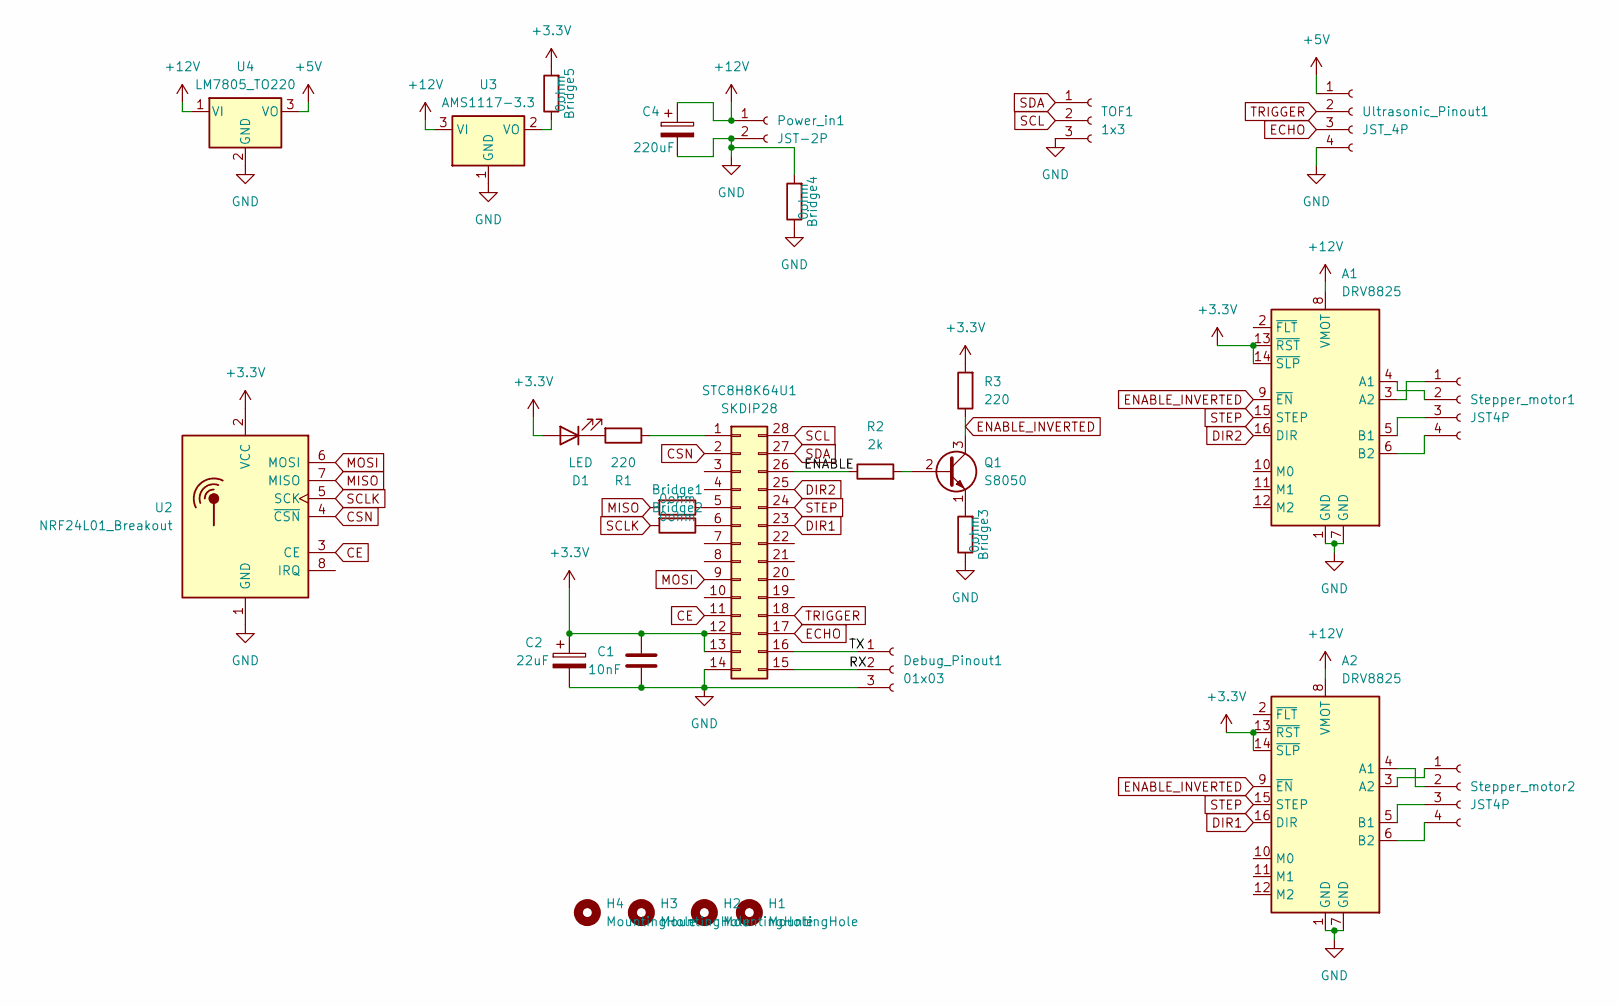
[picture p37: schematic axis_control_board.kicad_sch]

Parts:
A1, A2: DRV8825; Pololu_Breakout-16_15.2x20.3mm
Bridge1, Bridge2, Bridge3, Bridge4: 0ohm; R_Axial_DIN0207_L6.3mm_D2.5mm_P7.62mm_Horizontal
Bridge5: 0ohm; R_Axial_DIN0207_L6.3mm_D2.5mm_P5.08mm_Vertical
C1: 10nF; C_Disc_D5.0mm_W2.5mm_P2.50mm
C2: 22uF; CP_Radial_D5.0mm_P2.00mm
C4: 220uF; CP_Radial_D5.0mm_P2.50mm
D1: LED; LED_D3.0mm
Debug_Pinout1: 01x03; PinSocket_1x03_P2.54mm_Vertical
H1, H2, H3, H4: MountingHole; MountingHole_3.2mm_M3_Pad_TopOnly
Power_in1: JST-2P; JST_EH_B2B-EH-A_1x02_P2.50mm_Vertical
Q1: S8050; TO-92_Inline
R1, R3: 220; R_Axial_DIN0207_L6.3mm_D2.5mm_P7.62mm_Horizontal
R2: 2k; R_Axial_DIN0207_L6.3mm_D2.5mm_P7.62mm_Horizontal
STC8H8K64U1: SKDIP28; DIP-28_W7.62mm_LongPads
Stepper_motor1, Stepper_motor2: JST4P; JST_EH_B4B-EH-A_1x04_P2.50mm_Vertical
TOF1: 1x3; PinSocket_1x03_P2.54mm_Vertical
U2: NRF24L01_Breakout; nRF24L01_Breakout
U3: AMS1117-3.3; TO-220-3_Vertical
U4: LM7805_TO220; TO-220-3_Vertical
Ultrasonic_Pinout1: JST_4P; JST_EH_B4B-EH-A_1x04_P2.50mm_Vertical

Connections:
+3.3V: A1.13 (~RST), A1.14 (~SLP), A2.13 (~RST), A2.14 (~SLP), Bridge5.2, C1.2, C2.1, D1.2 (A), R3.2, STC8H8K64U1.12, STC8H8K64U1.13, U2.2 (VCC)
+5V: U4.3 (VO), Ultrasonic_Pinout1.1
+12V: A1.8 (VMOT), A2.8 (VMOT), C4.1, Power_in1.1, U3.3 (VI), U4.1 (VI)
/ENABLE: R2.1, STC8H8K64U1.26
/RX: Debug_Pinout1.2, STC8H8K64U1.15
/TX: Debug_Pinout1.1, STC8H8K64U1.16
CE: STC8H8K64U1.11, U2.3 (CE)
CSN: STC8H8K64U1.2, U2.4 (~CSN)
DIR1: A2.16 (DIR), STC8H8K64U1.23
DIR2: A1.16 (DIR), STC8H8K64U1.25
ECHO: STC8H8K64U1.17, Ultrasonic_Pinout1.3
ENABLE_INVERTED: A1.9 (~EN), A2.9 (~EN), Q1.3 (C), R3.1
GND: A1.1 (GND), A1.7 (GND), A2.1 (GND), A2.7 (GND), Bridge3.1, Bridge4.1, Bridge4.2, C1.1, C2.2, C4.2, Debug_Pinout1.3, Power_in1.2, STC8H8K64U1.14, TOF1.3, U2.1 (GND), U3.1 (GND), U4.2 (GND), Ultrasonic_Pinout1.4
MISO: Bridge1.2, U2.7 (MISO)
MOSI: STC8H8K64U1.9, U2.6 (MOSI)
unnamed: A1.4 (A1), Stepper_motor1.2
unnamed: A1.3 (A2), Stepper_motor1.1
unnamed: A1.5 (B1), Stepper_motor1.3
unnamed: A1.6 (B2), Stepper_motor1.4
unnamed: A2.4 (A1), Stepper_motor2.2
unnamed: A2.3 (A2), Stepper_motor2.1
unnamed: A2.5 (B1), Stepper_motor2.3
unnamed: A2.6 (B2), Stepper_motor2.4
unnamed: D1.1 (K), R1.2
unnamed: Q1.2 (B), R2.2
unnamed: Bridge3.2, Q1.1 (E)
unnamed: R1.1, STC8H8K64U1.1
unnamed: Bridge1.1, STC8H8K64U1.5
unnamed: Bridge2.1, STC8H8K64U1.6
unnamed: Bridge5.1, U3.2 (VO)
SCL: STC8H8K64U1.28, TOF1.2
SCLK: Bridge2.2, U2.5 (SCK)
SDA: STC8H8K64U1.27, TOF1.1
STEP: A1.15 (STEP), A2.15 (STEP), STC8H8K64U1.24
TRIGGER: STC8H8K64U1.18, Ultrasonic_Pinout1.2

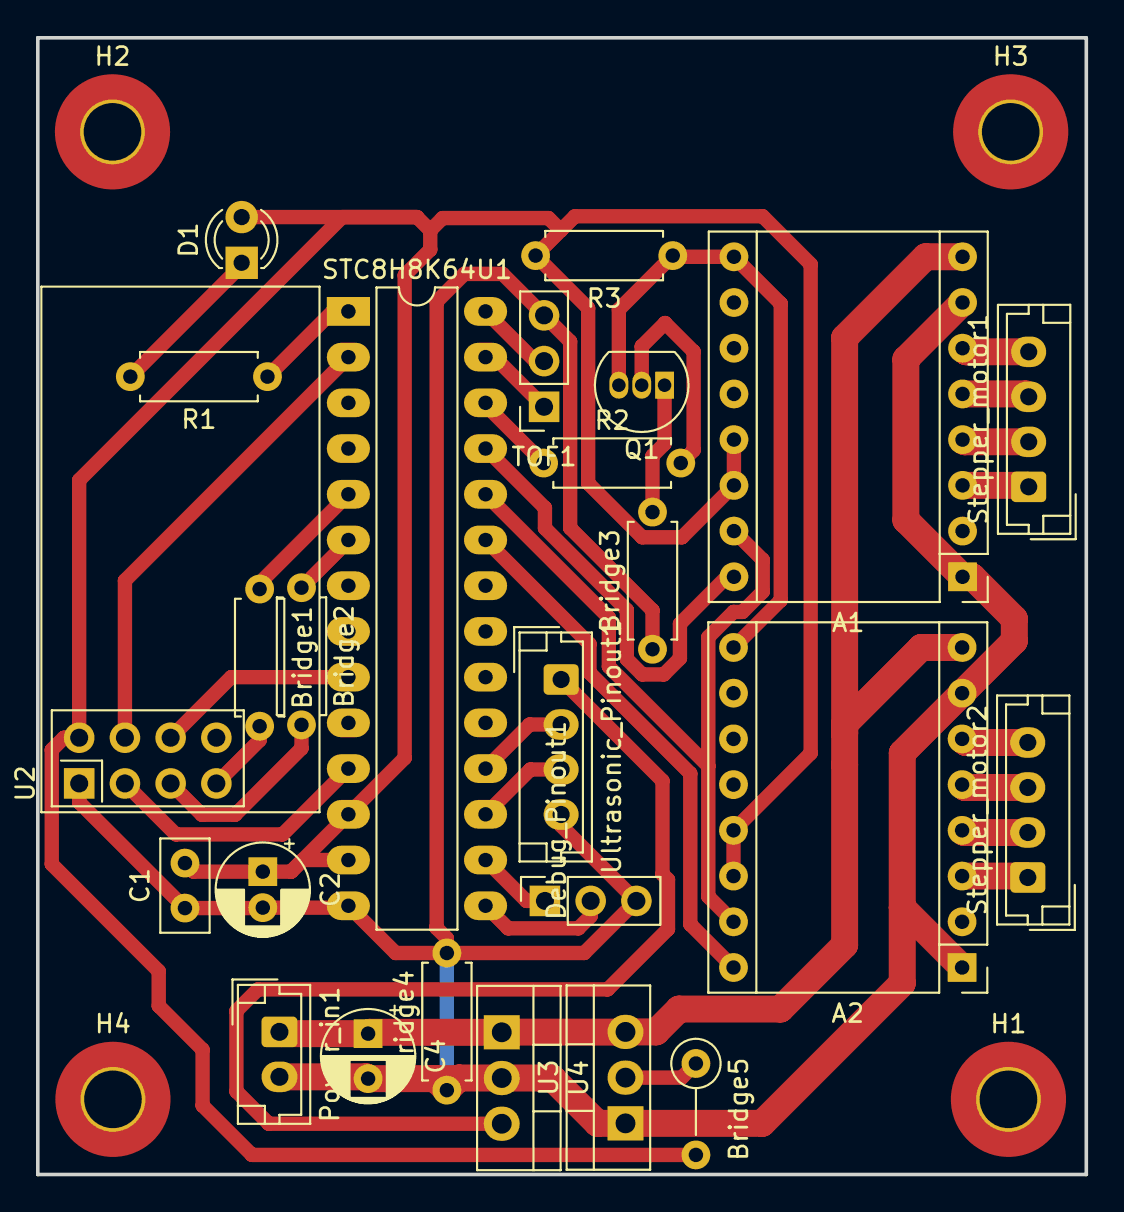
[picture p38: board axis_control_board.kicad_pcb from above]

Board: 2 copper layers, 58.2 x 63.2 mm, 29 parts (0 on the bottom side), 35 nets.
