ambadran/SIMACAS/Programming/axis_controller/project-defs.h

#ifndef PROJECT_DEFS_H
#define PROJECT_DEFS_H

/* AXIS NUMBER */
/* There are 3 axis in this system each communicating with the Main MCU through the nRF24L01
 * This means that each axis should use a different channel for communication
 */
#define AXIS_CHANNEL 58

 /* SPI settings */
#define SPI_PIN_CONFIG 0
#define SPI_SPEED 4000000UL

 /* Console settings */
#define CONSOLE_SPEED 115200
#define CONSOLE_UART UART1
#define CONSOLE_PIN_CONFIG 0
// uncomment to echo any character written and char count in terminal
#define ECHO_TERMINAL 

 /* nRF24L01 settings */
//uncomment to print all the nrf24l01 registers after setting them with nrf24_device()
#define PRINT_NRF24_REGISTERS 
#define NRF24_CSN_PORT 2
#define NRF24_CSN_PIN 7
#define NRF24_CE_PORT 5
#define NRF24_CE_PIN 4

/* Stepper Motor Settings */
#define STEPPER_MOTOR_PORT 2
#define STEPPER_ENABLE_PIN 3
#define STEPPER_DIR2_PIN 2
#define STEPPER_STEP_PIN 1
#define STEPPER_DIR1_PIN 0
#define DEFAULT_STEPPER_FREQUENCY 50
#define STEPPER_CM_TO_STEPS 100 //TODO: needs testing

/* Ultrasonic Sensor Settings*/
#define ULTRASONIC_TRIGGER_PORT 3
#define ULTRASONIC_TRIGGER_PIN 3
#define ULTRASONIC_ECHO_PORT 3
#define ULTRASONIC_ECHO_PIN 2
/* #define ULTRASONIC_STATE_MACHINE */


/* timer-hal configs */
#define HAL_TIMER_API_STOP_TIMER

#define STEPPER_TIMER TIMER2
#define STEPPER_TIMER_ISR timer2_isr
#define STEPPER_TIMER_INTERRUPT TIMER2_INTERRUPT

#define ULTRASONIC_TIMER TIMER3
#define ULTRASONIC_TIMER_ISR timer3_isr
#define ULTRASONIC_TIMER_INTERRUPT TIMER3_INTERRUPT

/* external pin interrupts */
#define ULTRASONIC_INT_PIN_ISR extint0_isr
#define ULTRASONIC_INT_PIN_INTERRUPT EXTINT0_INTERRUPT

// Others 
#define LED_PORT 2
#define LED_PIN 6
/* #define GPIO_HAS_INT_WK */

#include <STC/8H8KxxU/SKDIP28.h>
#include <stdio.h>
#include <stdint.h>
#include <string.h>
#include <delay.h>
#include <gpio-hal.h>
#include <spi-hal.h>
#include <uart-hal.h>
#include <serial-console.h>
#include <timer-hal.h>
#include "stepper_motor.h"
#include "nrf24l01.h"
#include "ultrasonic.h"
#include "terminal.h"
#include "protocol.h"

#endif
