ambadran/SIMACAS/Programming/axis_controller/terminal.c

#include "project-defs.h"

movement_type_t movement_type;
int16_t distance;  // in centi-meters

// reads int only not floats
bool read_int(char *line, uint8_t* char_count, int16_t* int_value_ptr) {

  char *ptr = line + *char_count; // the variable that will extract the next digit from
  unsigned char c; // the variable that will hold each digit

  c = *ptr++;  // extracting the next digit!

  // catching negative values :)
  bool isnegative = false;
  if (c == '-') {
    isnegative = true;
    c = *ptr++;

  // incrementing pointer anyway if +ve sign is there
  } else if (c == '+') {
    c = *ptr++;
  }

  // Algorithm to convert char digits to int
  uint32_t intval = 0;
  uint8_t ndigit = 0;  // current digit read index
  int8_t exp = 0;  // NOT uint8_t as this must hold +ve and -ve numbers
  while (1) {

    c -= '0';
    if (c <= 9) {
      ndigit++;
      if (ndigit <= MAX_INT_DIGITS) {

        intval = (((intval << 2) + intval) << 1) + c; // intval*10 + c
                                                      //
      } else {

        exp++;  // Drop overflow digits
      }

    } else {
      // encountered a non integer character
      break;
    }
    c = *ptr++;
  }

  // Return if no digits have been read.
  if (!ndigit) { return(false); };

  long int lival;
  lival = (long int)intval;
  
  if (exp > 0) {
    do {
      lival *= 10.0;
    } while (--exp > 0);
  } 

  // Assign floating point value with correct sign.    
  if (isnegative) {
    *int_value_ptr = -lival;
  } else {
    *int_value_ptr = lival;
  }

  *char_count = ptr - line - 1; // Set char_counter to next statement
 
  return (true);
}

LINE_STATUS terminal_execute_line(char* line) {

  uint8_t char_count = 0;
  char letter;
  // temporary int value that gets read from the terminal then assigned to another variable of any other c component
  uint16_t int_value;

  // To know whether to execute arg func routine or not
  uint8_t mode_func_ind = MODE_FUNC_NONE;

  // ultrasonic stuff
  uint16_t ultrasonic_dist = 0;
#if ULTRASONIC_STATE_MACHINE
  ULTRASONIC_STATUS ultrasonic_current_status = ultrasonic_get_distance(&ultrasonic_dist);
#endif

  while (line[char_count] != 0) {

    // Reading letter argument, aka which function to execute
    letter = line[char_count];

    // incrementing char_count for next iteration
    char_count++;

    // IMP: capital letters are command letters
    //      small letters are argument letters
    // Checking letter is a letter
    // checking if it's before A or after z or any character in between Z and a in the ascii table
    if ( letter < 'A' || letter > 'z' || (letter > 'Z' && letter < 'a')) {
      printf("\rExpected a letter!\n"); 
      return LINE_FAILED;
    }

    /* Identifying function and printing the resultant execution */
    switch(letter) {

      case 'A':
        // testing reading int argument
        if (!read_int(line, &char_count, &int_value)) {
          printf("Bad integer Number Format\n");
          return LINE_FAILED;
        }

        printf("Read INT value: %d\n", int_value);
        break;
   
      case 'M':
        // Move Command:
        // first argument is the direction 0 for backwards, 1 for forward. e.g M0 or M1
        // second argument is the value to move in centi-meters (f for float). e.g- M0 i30 -> move backwards 30cm
        // reading int argument
        if (!read_int(line, &char_count, &int_value)) {
          printf("Bad int Number Format\n");
          return LINE_FAILED;
        }

        // for catching second argument, activating error checking and execute routines
        mode_func_ind = MODE_FUNC_MOVE;

        // capturing direction value, will check it, execute it later
        movement_type = (movement_type_t)int_value;

        break;

      case 'i':
        // reading int argument for a multi-argument command
        if (!read_int(line, &char_count, &int_value)) {
          printf("Bad int Number Format\n");
          return LINE_FAILED;
        }

        switch(mode_func_ind) {
          case MODE_FUNC_MOVE:
            distance = int_value;
            break;
        }
        break;


#if ULTRASONIC_STATE_MACHINE
      case 'U':
        // reading int argument for a multi-argument command
        if (!read_int(line, &char_count, &int_value)) {
          printf("Bad int Number Format\n");
          return LINE_FAILED;
        }

        switch(int_value) {

          case 0:
            ultrasonic_stop_sequence();
            printf("Ultrasonic Sensor Cycle Stopped!\n");
            break;

          case 1:
            ultrasonic_start_sequence();
            printf("Ultrasonic Sensor Cycle Starting!\n");
            break;

          default:
            printf("Ultrasonic is either ON (1) or OFF (0)\n");
            break;

        }
        break;  //TODO: for some reason this break is needed for proper running
#endif

      case 'D':
        // reading int argument for a multi-argument command
        if (!read_int(line, &char_count, &int_value)) {
          printf("Bad int Number Format\n");
          return LINE_FAILED;
        }

#if ULTRASONIC_STATE_MACHINE
        ultrasonic_current_status = ultrasonic_get_distance(&ultrasonic_dist);

        if (ultrasonic_current_status == ULTRASONIC_ACTIVE) {

          printf("Ultrasonic Sensor is Active, Distance: %dcm \n", ultrasonic_dist);

        } else {

          printf("Ultrasonic status: %s\n", ULTRASONIC_STATUS_TO_STRING[ultrasonic_current_status]);

        }
#else
        mode_func_ind = MODE_FUNC_ULTRASONIC;
#endif
        break;

      default:
        printf("Command Letter Not Implemented\n");
        return LINE_FAILED;
    }

  }
  /* Parsing complete! (and non mode funcs are executed too)*/ 

  // The rest of the steps are only Applicable for Mode funcs
  if (mode_func_ind == MODE_FUNC_NONE) {
    return LINE_PASSED;
  }

  /* [ Step 3: Error checking ] */
  switch(mode_func_ind) {

    case MODE_FUNC_MOVE:

      // should be NEVER needed as it is tested in main loop
      if (get_stepper_state()) {
        printf("stepper_motor already stepper_active!\n");
        return LINE_FAILED;
      }

      // Direction Checks
      if (movement_type != MOVE_ABSOLUTE && movement_type != MOVE_RELATIVE) {
        printf("ERROR: Unsupported 'movement_type' value: %d expected '0' for absolute or '1' for relative\n", movement_type);
        return LINE_FAILED;
      }

      // Distance value Checks
      // TODO: check if maximum or minimum is met
      /* if (distance < 0) { */
      /*   printf("ERROR: can't move a negative distance!\n"); */
      /*   return LINE_FAILED; */
      /* } */

  }

  /* [ Step 4: Execute! ] */
  switch (mode_func_ind) {

    case MODE_FUNC_MOVE:

      stepper_motor_move(movement_type, distance);

      break;

    case MODE_FUNC_ULTRASONIC:
      printf("starting..\n");
      ultrasonic_get_distance(&ultrasonic_dist);
      printf("Ultrasonic measured distance: %dcm \n", ultrasonic_dist);

  }

  return LINE_PASSED;
}
