ambadran/SIMACAS/Programming/main_board/can_protocol.py

'''
Abstraction for CAN protocol, implemented using internal PIO block :D
'''

class CAN:
    '''
    Abstraction for CAN protocol, implemented using internal PIO block :D
    '''
    def __init__(self):
        pass
