ambadran/SIMACAS/(commit log)

2024-04-08 added axis_control circuit and programming files
    [axis_control_board.kicad_pcb, axis_control_board.kicad_sch]
2024-04-12 finished terminal component and stepper_motor component :D
2024-04-13 Now I call move_abs(distance) from upy and the steppers move through stc ;)
2024-04-13 added .shapr and .step file
    [SIMACAS.step]
2024-04-13 started developing ultrasonic drivers
2024-04-14 further dev in ultrasonic module
2024-04-14 finallized state machine design for ultrasonic sensor
2024-04-15 developing state machine algorithm for ultrasonic
2024-04-15 added BOM files
    [BOM.xlsx, water_distribution_BOM.xlsx]
2024-04-15 finished ultrasonic phase and status state machines c development with successful compilation, pending actual testing ;p
    [water_distribution_BOM.xlsx]
2024-04-15 added water pump pwm controller circuit
    [dc_motor_pwm_controller.kicad_pcb, dc_motor_pwm_controller.kicad_sch]
2024-04-16 added ultrasonic terminal commands
2024-04-16 hit a brick wall, MCU doesn't do anything, maybe stack overflow problem?!
    [main.c, project-defs.h, protocol.c, stepper_motor.c, terminal.c, terminal.h, ultrasonic.c]
2024-04-20 further development in axis control board
    [BOM.xlsx, axis_control_board.kicad_pcb, axis_control_board.kicad_sch, pcb_BOM.csv, water_distribution_BOM.xlsx]
2024-04-20 minor changes
    [dc_motor_pwm_controller.kicad_pcb, dc_motor_pwm_controller.kicad_sch, water_distribution_BOM.xlsx]
2024-04-20 finished axis control PCB design
    [BOM.xlsx, Main_board.kicad_pcb, Main_board.kicad_sch, axis_control_board.kicad_pcb, axis_control_board.kicad_sch, pcb_BOM.csv]
2024-04-21 added Gerber and Gcode files for axis control PCB
    [axis_control_board-F_Cu.gbr, mirrored_and_offseted.gbr]
2024-04-21 added BOMs and more gcode files
    [BOM.xlsx, axis_control_board.kicad_pcb, water_distribution_BOM.xlsx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]
2024-04-23 minor changes for axis control PCB
    [BOM.xlsx]
2024-05-11 updated axis_control PCB and fixed hardware bug
    [axis_control_board.kicad_pcb, axis_control_board.kicad_sch]
2024-05-11 started thesis and exported new axis pdfs
    [BOM.xlsx]
2024-05-13 minor deployment changes
    [water_distribution_BOM.xlsx]
2024-05-23 started web development for pico w
2024-05-23 website developed and functional, pending water irrigation buttons
2024-06-08 modified BOMs and created sensor_board electronics and programming files. Plus some file rearrangement
    [BOM.xlsx, BOM_Frame.xlsx, BOM_main_board.xlsx, BOM_sensor_board.xlsx, axis_control_board.kicad_pcb, axis_control_board.kicad_sch, sensor_board.kicad_pcb, sensor_board.kicad_sch]
2024-06-13 further development in sensor board
2024-06-13 finished sensor board PCB
    [axis_control_board.kicad_pcb, axis_control_board.kicad_sch, sensor_board.kicad_pcb, sensor_board.kicad_sch]
2024-06-14 finished implementing full terminal on sensor board :D
2024-06-14 finished all sensor_board code (except DHT11 bug and CAN module)
    [dh11.c, dh11.h, main.c, mq135.c, project-defs.h, protocol.c, soil_moisture.c]
2024-06-17 finished second wide sprinkler
    [axis_control_board.kicad_pcb, sensor_board.kicad_pcb, sprinkler_wide.stl]
2024-06-18 finished electronics side axis frame and battery holder
    [batteries_holder.stl]
2024-06-21 Main MCU now communicate with multiple nRF. Added Main Board Schematic
    [BOM.xlsx, Main_board.kicad_sch]
2024-06-21 Main Board Code re-written; finished actuators, html pages and started server-side handling
    [Main_board.kicad_pcb, Main_board.kicad_sch]
2024-06-22 Finished linking web app with Actuators ;)
2024-06-23 finished Main Board PCB
    [Main_board.kicad_pcb, Main_board.kicad_sch]
2024-06-23 added Main Board PDFs
    [Main_board.csv, Main_board.kicad_pcb]
2024-06-23 added Final .step & .shapr files for WHOLE Project
    [spacer.stl, sprinkler_wide.stl, sprinkler_wide_base.stl, sprinkler_wide_top.stl, sprinklers_wide.stl]
2024-06-23 added sensors.py
2024-06-24 Major Bug Fixes in Main Board
    [Main_board.kicad_pcb]
2024-06-25 added BOM
    [BOM_Frame.xlsx, axis_robot_assembly.xlsx, frame_assembly.xlsx, water_distribution_BOM.xlsx, water_distribution_system.xlsx]
2024-06-25 finished BOM
    [BOM.xlsx, BOM_main_board.xlsx, BOM_sensor_board.xlsx, axis_robot_assembly.xlsx, frame_assembly.xlsx, sensor_board.csv, water_distribution_system.xlsx]
2024-06-25 modified BOM
    [BOM.xlsx]
